IronHeartConsulting/IBPV2/Docs/Photos/thumb_IMG_0899_1024.jpg

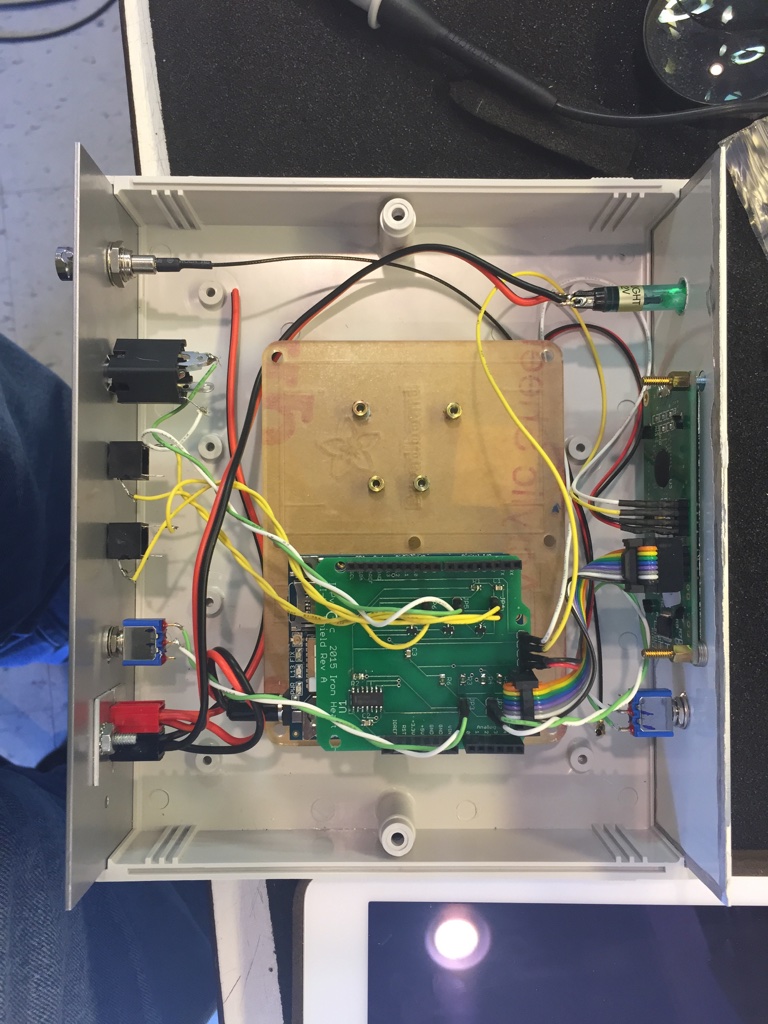
Docs/Photos/thumb_IMG_0899_1024.jpg
