IronHeartConsulting/IBPV2/Docs/Photos/IMG_0892_1024.jpg

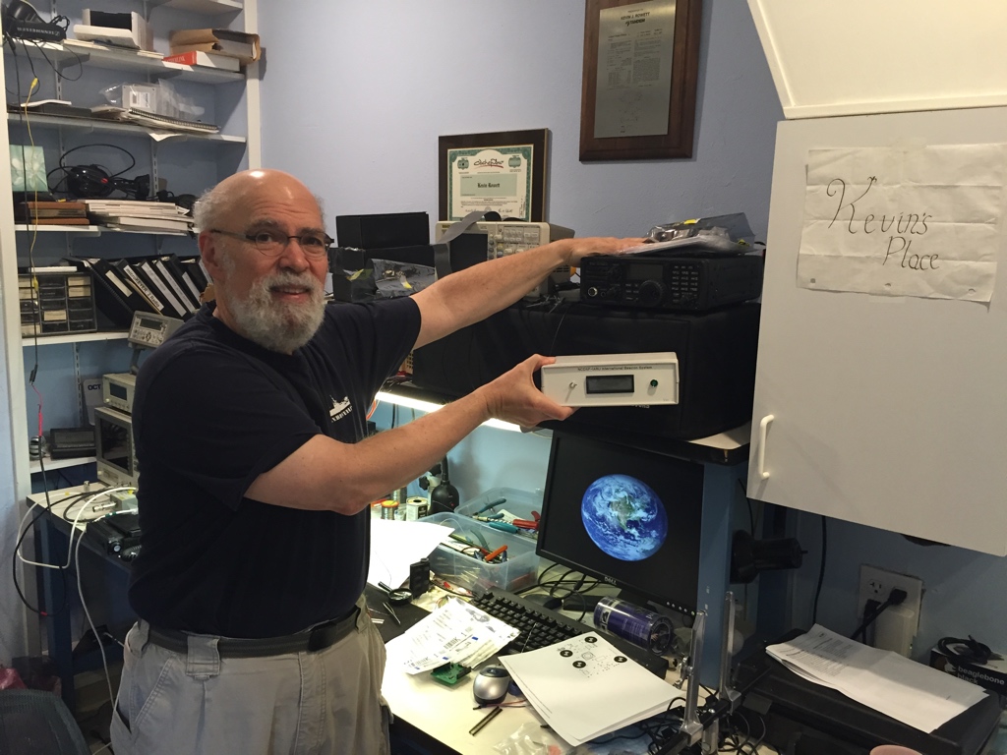
Docs/Photos/IMG_0892_1024.jpg
