IronHeartConsulting/IBPV2/Hardware/Electricial/Rev E controller/CI_V_Shield_Rev_D/Gerbers/readme.pdf

## readme.txt - Beacon Controller PCB

Iron Heart Consulting P/N 100-0004-500 Rev E 8/8/2016

Added Vscore layer - krowett - 8/8/16 - based on email with Sunstone

Stack Order | File suffix | Description | Eagle layer info, other notes
1 | .crc | Comp side Cream Frame | (31) tCream
2 | .plc | Comp side silk screen | (20) Dimension, (21) tPlace, (25), tNames
3 | .stc | Comp side solder stop mask | (29) tStop
4 | .cmp | Component Side | (1) top, (17) pads, (18) Vias
5 | .ly2 | Inner Layer - 2 | (2) Route2, (17) Pads, (18) Vias
6 | .l15 | Inner Layer -15 | (15) Route15, (17) Pads, (18) Vias
7 | .sol | Solder Side | (16) Bottom, (17) Pads, (18) Vias
8 | .sts | Solder Side solder stop mask | (30) bStop
9 | .pls | Solder side silk screen | (20) Dimension, (22) bPlace, (26) bNames

10 | .crc | Solder side Cream Frame | (32) bCream
11 | .vsc | VSCORE - board outline | (102) VScore
