IronHeartConsulting/IBPV2/Hardware/Enclosure/Mechanicals Rev B/connector_holes_mill_rear_endpanel.txt

( connector_holes_mill_rear_endpanel )
( File created: Wednesday September 21 2016 - 04:25 PM)
( for Mach2/3 from Vectric )
( Material Size)
( X= 6.000, Y= 6.000, Z= 0.063)
()
(Toolpaths used in this file:)
(connector holes)
(Tools used in this file: )
(1 = End Mill {0.125 inch})
N100G00G20G17G90G40G49G80
N110G70G91.1
N120T1M06
N130 (End Mill {0.125 inch})
N140G00G43Z0.8000H1
N150S12000M03
N160(Toolpath:- connector holes)
N170()
N180G94
N190X0.0000Y0.0000F10.0
N200G00X1.7092Y2.9206Z0.2000
N210G1Z-0.0630F4.0
N220G1X1.7150Y2.9179F10.0
N230G1X1.7211Y2.9157
N240G1X1.7273Y2.9142
N250G1X1.7337Y2.9134
N260G1X1.7402Y2.9132
N270G1X1.7468Y2.9137
N280G1X1.7532Y2.9149
N290G1X1.7618Y2.9176
N300G1X1.7708Y2.9214
N310G1X1.7735Y2.9229
N320G1X1.7768Y2.9251
N330G1X1.7801Y2.9279
N340G1X1.7835Y2.9311
N350G1X1.7868Y2.9348
N360G1X1.7899Y2.9390
N370G1X1.7928Y2.9434
N380G1X1.7954Y2.9481
N390G1X1.7976Y2.9530
N400G1X1.7995Y2.9579
N410G1X1.8009Y2.9628
N420G1X1.8019Y2.9675
N430G1X1.8025Y2.9719
N440G1X1.8027Y2.9759
N450G1X1.8026Y2.9795
N460G1X1.8022Y2.9826
N470G1X1.8001Y2.9914
N480G1X1.7973Y2.9990
N490G1X1.7940Y3.0056
N500G1X1.7902Y3.0114
N510G1X1.7858Y3.0166
N520G1X1.7805Y3.0214
N530G1X1.7743Y3.0259
N540G1X1.7660Y3.0306
N550G1X1.7582Y3.0343
N560G1X1.7576Y3.0345
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
%
