IronHeartConsulting/IBPV2/Docs/Photos/IMG_0868_1024.jpg

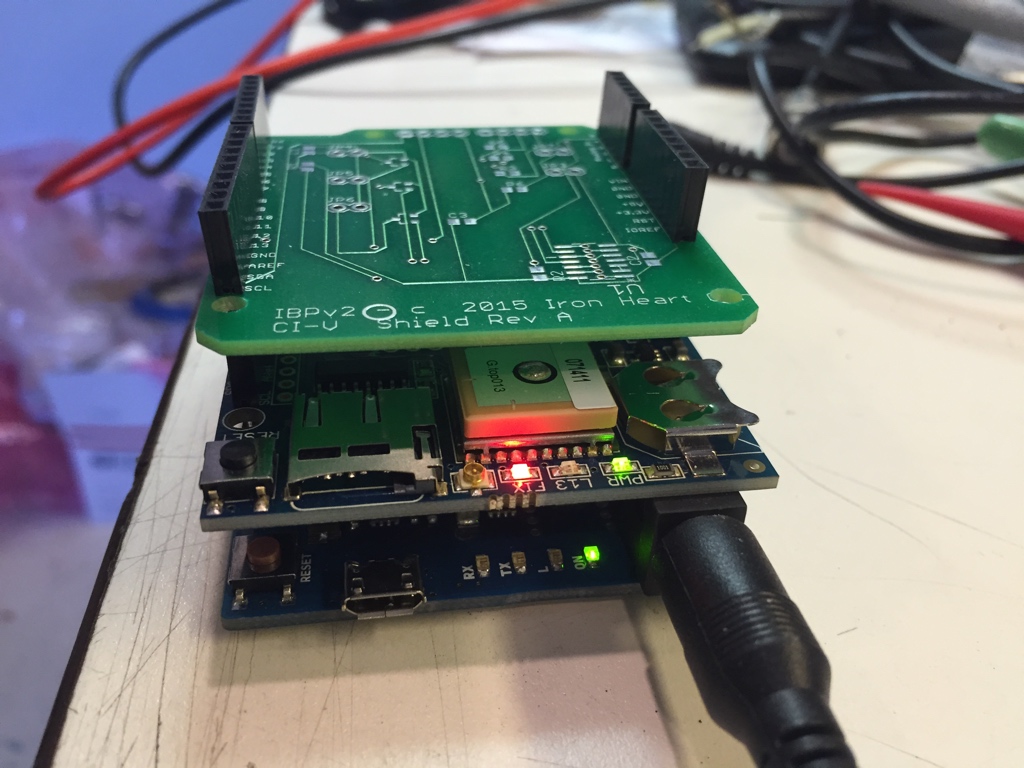
Docs/Photos/IMG_0868_1024.jpg
