IronHeartConsulting/IBPV2/Docs/Photos/IMG_0886_1024.jpg

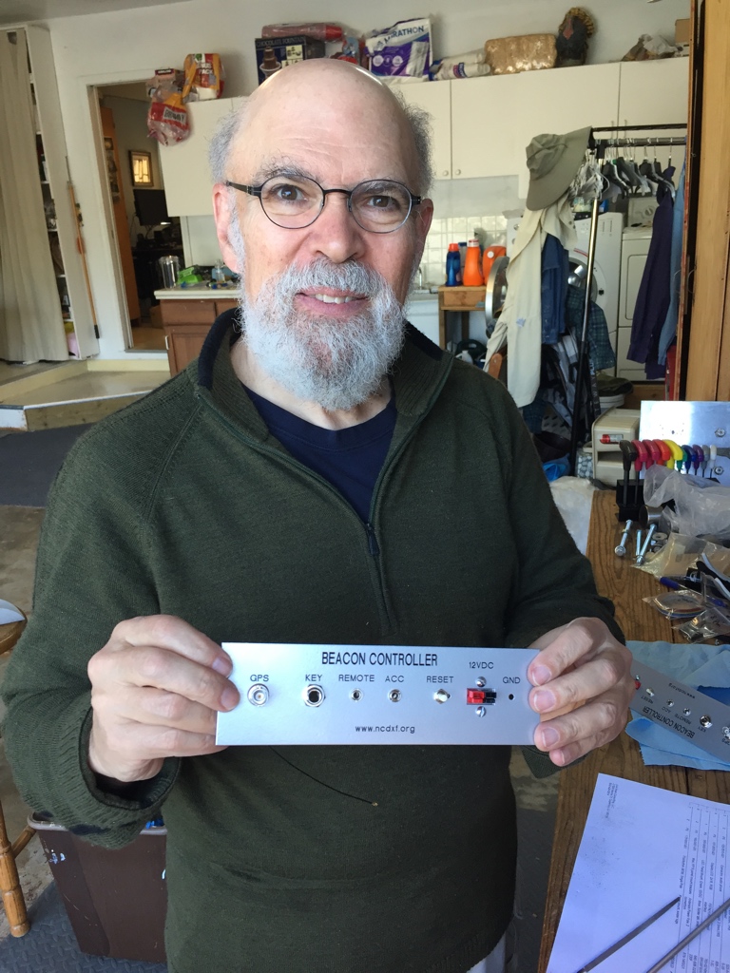
Docs/Photos/IMG_0886_1024.jpg
