IronHeartConsulting/IBPV2/Docs/Photos/IMG_0894_1024.jpg

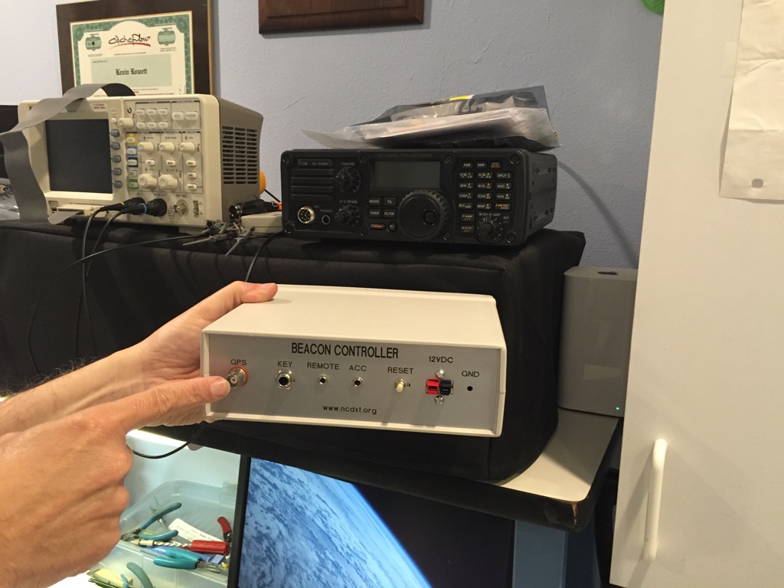
Docs/Photos/IMG_0894_1024.jpg
