IronHeartConsulting/IBPV2/Docs/Photos/IMG_0913.JPG

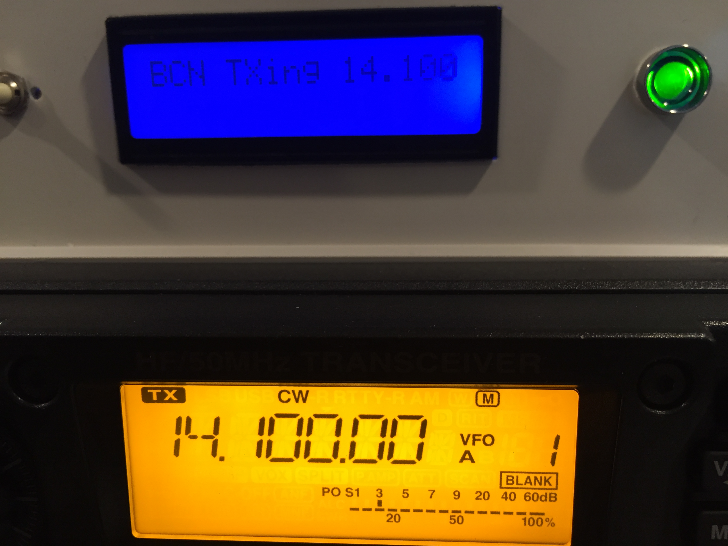
Docs/Photos/IMG_0913.JPG
