IronHeartConsulting/IBPV2/Docs/waveforms/NewFile4.bmp

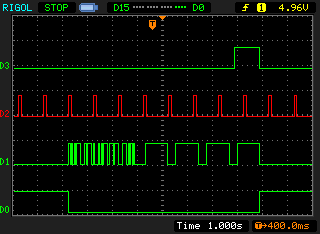
Docs/waveforms/NewFile4.bmp
