IronHeartConsulting/IBPV2/Docs/waveforms/NewFile5.bmp

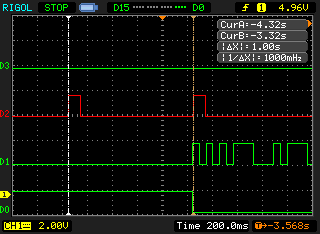
Docs/waveforms/NewFile5.bmp
