IronHeartConsulting/IBPV2/Docs/waveforms/NewFile6.bmp

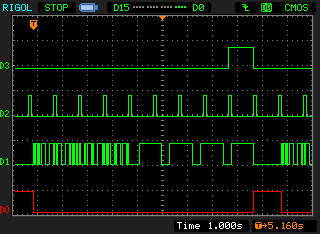
Docs/waveforms/NewFile6.bmp
