IronHeartConsulting/IBPV2/Hardware/ECOs/ECO_1_CI_V_drawing.png

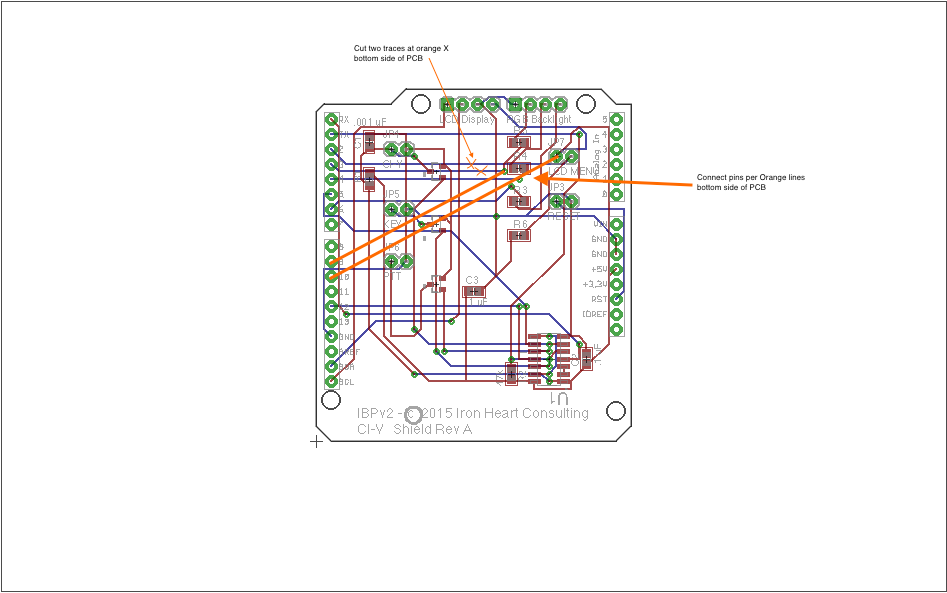
Hardware/ECOs/ECO_1_CI_V_drawing.png
