IronHeartConsulting/IBPV2/Hardware/Enclosure/Outside_label.graffle/image1.png

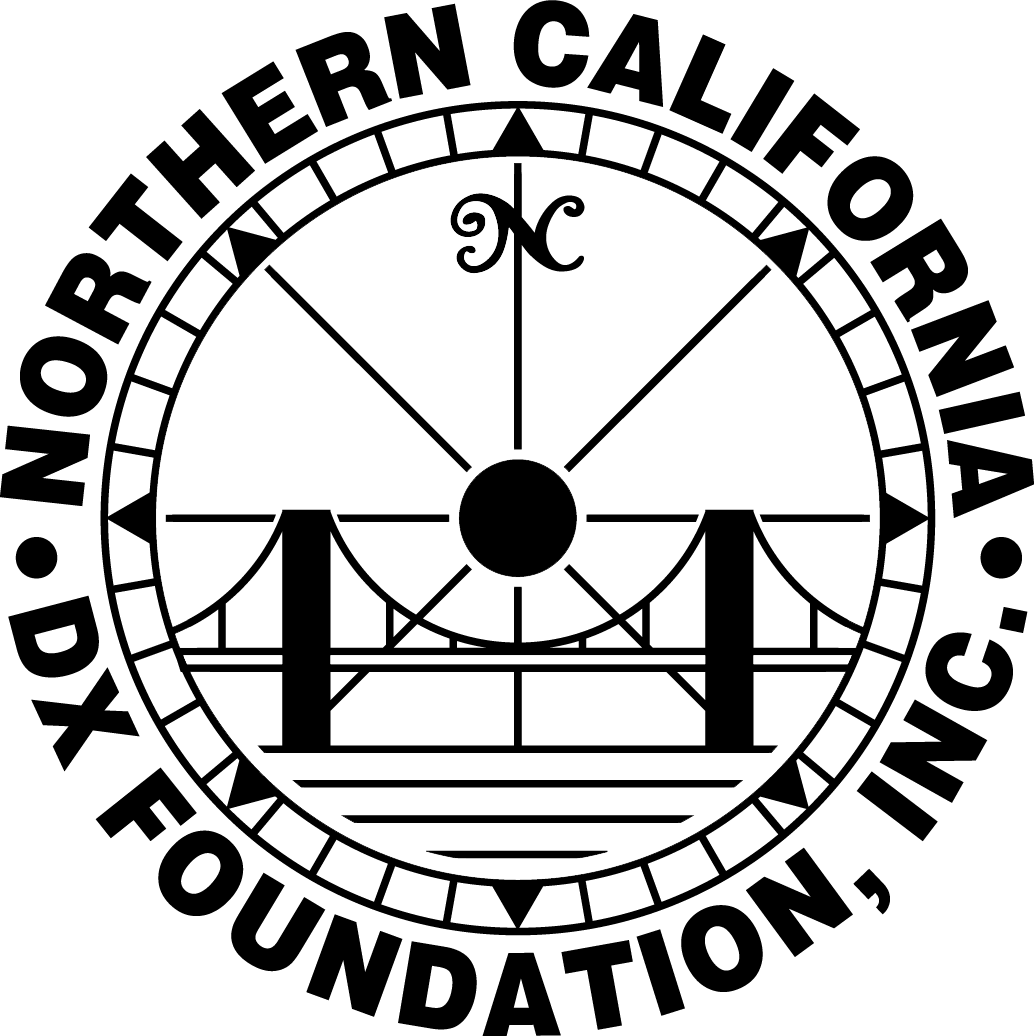
Hardware/Enclosure/Outside_label.graffle/image1.png
