IronHeartConsulting/IBPV2/Hardware/Electricial/Rev E controller/SC Release/100-0004-100_BOM.xlsx

Sheet: 100-0004-200 Rev E
Item Num | Qty | Value | Part Num | Package | REFDES | Description | Detail | VID | Vendor Part Num | mfg name | mfg part number | pkg code | Notes
1 | 3 | FIDUCIAL | * | FIDUCIAL_1MM | U$1, U$6, U$7 | * | * | * | * | * | * | * | DNP
2 | 3 | 220 | 110-0001-010 | R0805 | R1, R3, R11 | Resistor, SMD, 0805, thick film, 1%, 1/4W | 220ohm | ME | 660-SG73S2ATTD2200F | KOA Speer | SG73S2ATTD2200F | 805
3 | 1 | 330 | 110-0001-012 | R0805 | R4 | Resistor, SMD, 0805, thick film, 1%, 1/4W | 330 | ME | 660-SG73S2ATTD3300F | KOA Speer | SG73S2ATTD3300F | 805
4 | 1 | 4.7k | 110-0001-020 | R0805 | R6 | Resistor, SMD, 0805, thick film, 1%, 1/4W | 4.7k | ME | 660-SG73S2ATTD4701F | KOA Speer | SG73S2ATTD4701F | 805
5 | 1 | 10k | 110-0001-025 | R0805 | R5 | Resistor, SMD, 0805, thick film, 1%, 1/4W | 10k | ME | 660-SG73S2ATTD1002F | KOA Speer | SG73S2ATTD1002F | 805
6 | 1 | 10 | 110-0001-027 | 805 | R16 | Resistor, SMD, 0805, thick film, 1%, 1/4W | 10 | ME | 660-SG73P2ATTD10R0F | KOA Speer | SG73P2ATTD10R0F | 805
7 | 1 | 1k | 110-0001-029 | R0805 | R10 | Resistor, SMD, 0805, thick film, 1%, 1/4W | 1K | ME | 660-SG73S2ATTD1001F | KOA Speer | SG73S2ATTD1001F | 805
8 | 1 | 47k | 110-0001-030 | R0805 | R2 | Resistor, SMD, 0805, thick film, 1%, 1/4W | 47k | ME | 660-SG73S2ATTD4702F | KOA Speer | SG73S2ATTD4702F | 805
9 | 1 | 1.47M | 110-0002-010 | 805 | R12 | Resistor, SMD, 0805, thick film, 1%, 1/8W | 1.4M | ME | 660-RK73H2ATTD1404F | KOA Speer | RK73H2ATTD1404F | 805
10 | 1 | 280k | 110-0002-015 | 805 | R7 | Resistor, SMD, 0805, thick film, 1%, 1/8W | 280k | ME | 660-RK73H2ATTD2803F | KOA Speer | RK73H2ATTD2803F | 805
11 | 1 | 187k | 110-0002-030 | 805 | R9 | Resistor, SMD, 0805, thick film, 1%, 1/8W | 187k | ME | 660-RK73H2ATTD1873F | KOA Speer | RK73H2ATTD1873F | 805
12 | 1 | 105k | 110-0003-010 | 805 | R17 | Resistor, SMD, 0805, thin film, .1%, 100mW, 10ppm | 105k | ME | 279-RN73C2A105KBTDF | TE | RN73C2A105KBTDF | 805
13 | 1 | 1uF | 120-0001-009 | 805 | C4 | Cap, SMD, 0805, MLCC, X7R, 15% Tol, 50V | 1 uF | ME | 80-C0805C105K5R | KEMET | C0805C105K5R | 805
14 | 3 | .1 uF | 120-0001-010 | C0805 | C1, C2, C15 | Cap, SMD, 0805, MLCC, X7R, 15% Tol, 50V | .1 uF | ME | 80-C0805C104K5R | KEMET | C0805C104K5R | 805
15 | 1 | 47nF | 120-0001-013 | 805 | C9 | Cap, SMD, 0805, MLCC, X7R, 15% Tol, 50V | .047uF | ME | 80-C0805C473K5R | KEMET | C0805C473K5R | 805
16 | 1 | .001 uF | 120-0001-015 | C0805 | C3 | Cap, SMD, 0805, MLCC, X7R, 15% Tol, 50V | .001uF | ME | 80-C0805C102K5R | KEMET | C0805C102K5R | 805
17 | 1 | .01uF | 120-0001-020 | 805 | C6 | Cap, SMD, 0805, MLCC, X7R, 15% Tol, 50V | .01 uF | ME | 80-C0805C103K5R | KEMET | C0805C103K5R | 805
18 | 1 | .22uF | 120-0001-022 | 805 | C23 | Cap, SMD, 0805, MLCC, X7R, 15% Tol, 50V | .22 uF | ME | 80-C0805C224K5R | KEMET | C0805C224K5RACTU | 805
19 | 1 | 2.2uF | 120-0002-011 | 805 | C22 | CAP, SMD, 0805, MLCC, X7F, 16V, 10% | 2.2uF | ME | 963-EMK212B7225KG-T | Taiyo Yuden | EMK212B7225KG-T | 805
20 | 1 | 10uF | 120-0003-010 | 1210 | C7 | Cap, SMD, 1210, MLCC, X7R, 10% Tol, 25V | 10uF | ME | 963-TMK325B7106KN-TR | Taiyo Yuden | TMK325B7106KN-TR | 1210
21 | 2 | 4.7uF | 120-0003-011 | 1210 | C5, C21 | Cap, SMD, 1210, MLCC, X7R, 10% Tol, 25V | 4.7uF | ME | 963-TMK325B7475KN-T | Taiyo Yuden | TMK325B7475KN-T | 1210
22 | 1 | 47pF | 120-0004-010 | 805 | C10 | Cap, SMD, 0805, MLCC, C0G, 5% Tol, 50V | 47pF | ME | 80-C0805C470J5G | KEMET | C0805C470J5G | 805
23 | 1 | 22pF | 120-0004-011 | 805 | C8 | Cap, SMD, 0805, MLCC, C0G, 5% Tol, 50V | 22pF | ME | 80-C0805C220J5G | KEMET | C0805C220J5G | 805
24 | 1 | 5pF | 120-0004-013 | 805 | C20 | Cap, SMD, 0805, MLCC, C0G, 5% Tol, 50V | 5.6pF | ME | 80-C0805C569J5G | KEMET | C0805C569J5G | 805
25 | 1 | 100uF | 120-0005-050 | CAPCP6032X280N | C11 | Cap, SMD, 2312, TANT, 10V | 100uF | ME | 581-TPSC107M010R0075 | AVX | TPSC107M010R0075 | 2312
26 | 2 | CTL Signals | 125-0019-001 | 1X08_PIN1_NO_SILK | JP1,JP3 | header, right angle 1 rows, 10p, 2.54mm | THT | ME | 710-61301011021 | Wurth | 61301011021 | * | Made From
27 | 1 | MENU BTN | 125-0019-001 | 1X02 | JP2 | header, right angle 1 rows, 10p, 2.54mm | THT |  |  |  |  |  | Made From
28 | 1 | SMA-SMD | 125-0020-001 | SMA-SMD | X2 | Connector,RF, SMA, SMD, GOLD | Right Angle | ME | 530-142-0701-301 | Cinch | 142-0701-301 | *
29 | 1 | MBRA140 | 140-0001-001 | SMA-DIODE | D2 | DIO,SMD,Schottky, 1A, 40V | MBRA140 | ME | 863-MBRA140T3G | On Semi | MBRA140T3G | *
30 | 1 | PMEG4005EJ | 140-0003-001 | SOD-323 | D3 | DIO,SMD,Schottky, 40V, 200mW | PMEG4005EJ | ME | 771-PMEG4005EJ-T/R | NXP | PMEG4005EJ,115 | SOD-323
31 | 1 | 500mA | 145-0001-001 | R1206 | F1 | FUSE,SMD, 500mA, 1206, fast blow | * | ME | 581-F1206B0R50FSTR | AVX | F1206B0R50FSTR | 1206
32 | 1 | 100uH | 155-0001-001 | SLF7045 | L2 | INDUCTOR, SMD, 100uH | .5 AMPS, Switching PS | ME | 810-SLF7045T-101M | TDK | SLF7045T-101MR50-PF | *
33 | 1 | 47nH | 155-0002-001 | 805 | L1 | INDUCTOR,SMD, 47nH | 1.25A, SRF 1500MHz, 0805 | ME | 81-LQW2BAN47NJ00L | Murata | LQW2BAN47NJ00L | *
34 | 1 | 4.7uH | 155-0003-001 | 805 | L5 | INDUCTOR,SMD, 4.7uH, SMD, 0805 | 300mA | ME | 81-LQH2MCN4R7M02L | Murata | LQH2MCN4R7M02L | 805
35 | 1 |  | 155-0004-001 | L2012C | L3 | INDUCTOR, FB, SMD, 10mOhm | * | ME | 81-BLM21PG220SZ1D | Murata | BLM21PG220SZ1D | 805
36 | 1 |  | 160-0007-001 | CHIPLED_0805 | GPSLOCK | LED, SMD,CHIPLED, 0805, 45mcd | Green | ME | 720-LGR971-KN-1 | OSRAM | LGR971-KN-1 | 805
37 | 1 |  | 165-0001-001 | CR1220-SMD | BH2 | Battery holder, single coin cell, 12mm, SMD | CR1220 style | ME | 534-3000TR | Keystone | 3000TR | * | On BOTTOM
38 | 3 | MOSFET-NCHANNELBSS123LT1G | 185-0001-001 | SOT23-3 | Q1, Q2, Q3 | MOSFET, N-channel, SMD | Enh, 60V, 1.3ohm | ME | 771-2N7002P-215 | NXP | 2N7002P,215 | *
39 | 1 | MC74HC14ADG | 200-0001-001 | SOIC127P600X175-14N | U1 | Inverter, HC14, SMD | * | ME | 863-MC74HC14ADG | On Semiconductor | MC74HC14ADG | *
40 | 1 | LT1761ES5-5PBF | 230-0002-001 | SOT95P280X100-5N | U2 | LDO, 100mA, 5V, TSOT-23-5 | Micropower, Low Noise | DK | LT1761ES5-5#TRPBFCT-ND | Linear | LT1761ES5-5#PBF | *
41 | 1 | LTC3631IMS8EPBF | 230-0003-001 | SOP65P490X110-9N | U3 | switch controller, Buck, current mode | MS8E | LTC | LTC3631EMS8E#PBF | Linear | LTC3631EMS8E#PBF | *
42 | 1 | LT3483IS6PBF | 230-0005-001 | SOT95P280X100-6N | U8 | Buck, Boost, Charge Pump, Flyback Switching Regulator IC Negative Adjustable -2.5V 1 Output 170mA (Switch) | Negative | DK | LT3483ES6#TRMPBFCT-ND | Linear | LT3483ES6#TRMPBF | TSOT-23
43 | 1 |  | 240-0001-001 | FGPMMOPA6H | U5 | IC,SMD, GPS receiver | MT3339 | AF | 790 | GTOP | FGPMMOPA6H | *
44 | 2 | 8p | 125-0022-002 | header |  | header, vertical 1 rows, 8p, 2.54mm | THT |  |  |  |  |  | Insert from Bottom
45 | 1 | 10p | 125-0022-001 | header |  | header, vertical 1 rows, 10p, 2.54mm | THT |  |  |  |  |  | Insert from Bottom
44 | 1 | 6p | 125-0022-003 | header |  | header, vertical 1 rows, 6p, 2.54mm | THT |  |  |  |  |  | Insert from Bottom

Sheet: On-Hand
Iem Num | Qty | Value | Part Num | QTY On Hand
1 | 3 | FIDUCIAL | * | infinite
2 | 3 | 220 | 110-0001-010 | plenty
3 | 1 | 330 | 110-0001-012 | plenty
4 | 1 | 4.7k | 110-0001-020 | plenty
5 | 1 | 10k | 110-0001-025 | plenty
6 | 1 | 10 | 110-0001-027 | 39
7 | 1 | 1k | 110-0001-029 | 39
8 | 1 | 47k | 110-0001-030 | 100
9 | 1 | 1.47M | 110-0002-010 | plenty
10 | 1 | 280k | 110-0002-015 | plenty
11 | 1 | 187k | 110-0002-030 | plenty
12 | 1 | 105k | 110-0003-010 | 39
13 | 1 | 1uF | 120-0001-009 | plenty
14 | 3 | .1 uF | 120-0001-010 | plenty
15 | 1 | 47nF | 120-0001-013 | 39
16 | 1 | .001 uF | 120-0001-015 | plenty
17 | 1 | .01uF | 120-0001-020 | 39
18 | 1 | .22uF | 120-0001-022 | 39
19 | 1 | 2.2uF | 120-0002-011 | 39
20 | 1 | 10uF | 120-0003-010 | plenty
21 | 2 | 4.7uF | 120-0003-011 | 78
22 | 1 | 47pF | 120-0004-010 | plenty
23 | 1 | 22pF | 120-0004-011 | plenty
24 | 1 | 5pF | 120-0004-013
25 | 1 | 100uF | 120-0005-050 | 39
26 | 2 | CTL Signals | 125-0019-001 | 0
27 | 1 | MENU BTN | 125-0019-001 | 0
28 | 1 | SMA-SMD | 125-0020-001 | 0
29 | 1 | MBRA140 | 140-0001-001 | 39
30 | 1 | PMEG4005EJ | 140-0003-001 | 0
31 | 1 | 500mA | 145-0001-001 | 35
32 | 1 | 100uH | 155-0001-001 | plenty
33 | 1 | 47nH | 155-0002-001 | plenty
34 | 1 | 4.7uH | 155-0003-001 | 38
35 | 1 |  | 155-0004-001 | 39
36 | 1 |  | 160-0007-001 | 38
37 | 1 |  | 165-0001-001 | 39
38 | 3 | MOSFET-NCHANNELBSS123LT1G | 185-0001-001 | plenty
39 | 1 | MC74HC14ADG | 200-0001-001 | plenty
40 | 1 | LT1761ES5-5PBF | 230-0002-001 | 40
41 | 1 | LTC3631IMS8EPBF | 230-0003-001 | enough
42 | 1 | LT3483IS6PBF | 230-0005-001 | 38
43 | 1 |  | 240-0001-001 | 25
44 | 2 | 8p | 125-0022-002 | 0
45 | 1 | 10p | 125-0022-001 | 0
44 | 1 | 6p | 125-0022-003 | 0

Sheet: Top level
Level | Item Num | Qty | Part Num | Description | Detail | VID | Vendor Part Num | mfg name | mfg part number | Notes
1 |  | 1 | 040-0001-001 | Beacon Package | V2
2 |  | 1 | 040-0002-001 | Assembled Controller package
2 |  | 1 |  | Antenna, vertical, 5 band, strengthened
2 |  | 1 |  | Antenna, GPS Timing, N connector, 26dB
2 |  | 1 |  | Power Supply, 12VDC, 30AMP, 110/220 input
2 |  | 1 |  | Cable, Coax, RG-213, PL259 to PL259, UV | ?? Ft
2 |  | 1 |  | Cable, Coax, LMR-400, N to sma, UV | 50 ft
2 |  |  |  | Lightning Arrestor,
2 |  |  |  | Doc, Installation
2 |  |  |  | Label, controller
 |  |  |  | PCBA, beacon controller | Rev E
 |  |  |  | Arduino, Leonardo
 |  |  |  | Doc, mods, Leonardo | Rev A
 |  |  |  | Mated controller boards
 |  |  |  | Front End Panel
 |  |  |  | Blank, Endpanel
 |  |  |  | DWG, front endpanel fabrication
 |  |  |  | LCD Display
 |  | 4 |  | Nuts, 4-40
 |  |  |  | Pushbutton | Menu
 |  |  |  | Power Indicator | Green
 |  |  |  | DWG, Label, Front End Panel
 |  |  |  | Assembly Instructions
 |  |  |  | Rear End Panel
 |  |  |  | Blank, Endpanel
 |  |  |  | DWG, rear endpanel fabrication
 |  |  |  | Connector, Circular, DIN, Flange | 8p
 |  | 4 |  | Nuts, 4-40
 |  |  |  | screws, 4-40, pan head | ?? Length
 |  |  |  | Pushbutton | reset
 |  |  |  | DWG, Label, Rear End Panel
 |  |  |  | Assembly Instructions
 |  |  |  | pan
 |  |  |  | DWG, pan fabrication
 |  |  |  | stand-offs, swage, 4-40, .187 OD, 3/16 L | 6"
 |  |  |  | Cable, Coax, RG-316, SMA M RA-SMA F panel mount
 |  |  |  | Cable, assembly, LCD
 |  |  |  | Cable, assembly, control
 |  |  |  | Cable, assembly, menu button
 |  |  |  | Doc, assembly, controller chassis
 |  | 4 |  | screws, 4-40 | secure PCBAs
 |  | 4 |  | Spacers, round, #4 bore, nylon | CI-V to Leo
 |  |  |  | Enclosure
