IronHeartConsulting/IBPV2/Hardware/Electricial/Power_Injector_Asm_kit.xlsx

Item | Qty | P/N | Title | Detail | Ref(m) | Vend-P/N | Mfr | Mfr-P/N
Top |  | 100-0002-200 | PCA, Power Injector, GPS Antenna | 5V, 35mA from 7-12VDC
1 | 1 | 120-0003-010 | Cap, SMD, 1210, MLCC, X7R, 10% Tol, 25V | 10uF | C4 | 963-TMK325B7106KN-TR | Taiyo Yuden | TMK325B7106KN-TR
2 | 1 | 120-0002-009 | CAP, SMD, 0805, MLCC, X7F, 16V, 10% | 4.7uF | C6 | 963-EMK212B7475KG-T | Taiyo Yuden | EMK212B7475KG-T
3 | 1 | 125-0011-001 | header, straight, 1 rows, 2p, 2.54mm | THT | JP1
4 | 1 | 155-0001-001 | INDUCTOR, SMD, 100uH | .5 AMPS, Switching PS | L1 | 810-SLF7045T-101M | TDK | SLF7045T-101MR50-PF
5 | 1 | 120-0001-010 | Cap, SMD, 0805, MLCC, X7R, 15% Tol, 50V | .1 uF | C1 | 80-C0805C104K5R
6 | 1 | 120-0001-009 | Cap, SMD, 0805, MLCC, X7R, 15% Tol, 50V | 1 uF | C2 | 80-C0805C105K5R
7 | 1 | 120-0004-010 | Cap, SMD, 0805, MLCC, C0G, 5% Tol, 50V | 47pF | C7 | 80-C0805C470J5G
8 | 1 | 120-0004-011 | Cap, SMD, 0805, MLCC, C0G, 5% Tol, 50V | 22pF | C9 | 80-C0805C220J5G
9 | 2 | 125-0013-001 | u.FL, SMT, male recept, gold |  | J1,J2 | 798-UFLRSMT101 | Hirose | U.FL-R-SMT-1(01)
10 | 1 | 110-0002-010 | Resistor, SMD, 0805, thick film, 1%, 1/8W | 1.4M | R1 | 660-RK73H2ATTD1404F
11 | 1 | 110-0002-015 | Resistor, SMD, 0805, thick film, 1%, 1/8W | 280k | R3 | 660-RK73H2ATTD2803F
12 | 1 | 155-0002-001 | INDUCTOR,SMD, 47nH | 1.25A, SRF 1500MHz, 0805 | L2 | 81-LQW2BAN47NJ00L | Murata | LQW2BAN47NJ00L
13 | 1 | 230-0003-001 | switch controller, Buck, current mode | MS8E | U2 | LTC3631EMS8E#PBF
 |  |  |  |  |  | LTC3631EMS8E#PBF-ND | Linear | LTC3631EMS8E#PBF
14 | 1 | 230-0002-001 | LDO, 100mA, 5V, TSOT-23-5 | Micropower, Low Noise | U1 | LT1761ES5-5#PBF
 |  |  |  |  |  | LT1761ES5-5#TRPBFCT-ND | Linear | LT1761ES5-5#PBF
15 | 1 | 110-0002-020 | Resistor, SMD, 0805, thick film, 1%, 1/8W | 187k | R2 | 660-RK73H2ATTD1870F
16 | 1 | 100-0002-500 | PCB, Power Injector, GPS Antenna | Eagle BRO (CAD) FILE |  |  | Sunstone PCB
