IronHeartConsulting/IBPV2/Hardware/Electricial/Rev E controller/CI_V_Shield_Rev_D/CI_V.dxf

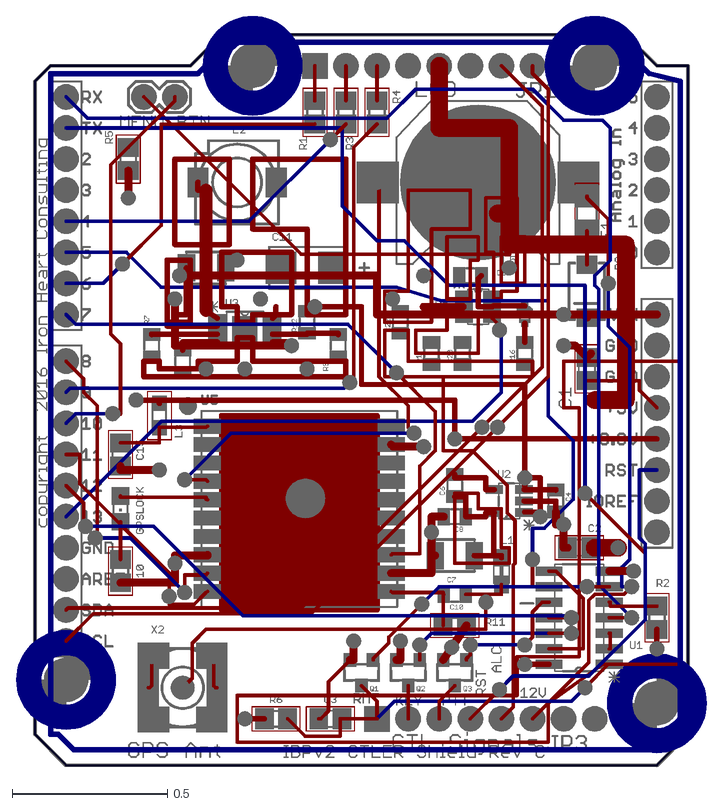
[picture p13: CAD file, 2016-09-22]
Hardware/Electricial/Rev E controller/CI_V_Shield_Rev_D/CI_V.dxf
2.22 x 2.42
