IronHeartConsulting/IBPV2/Hardware/Enclosure/Mechanicals Rev B/rear_endpanel.stl

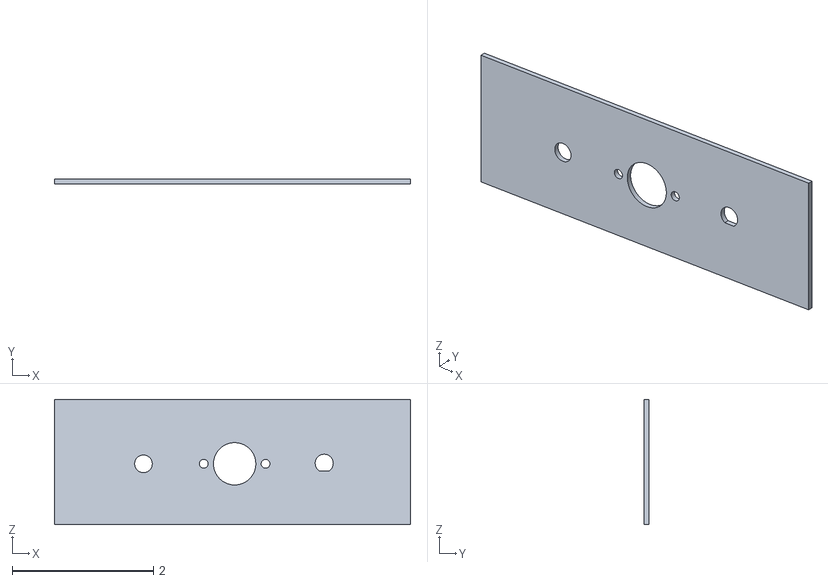
[picture p14: CAD file, 2016-09-22]
Hardware/Enclosure/Mechanicals Rev B/rear_endpanel.stl
5.04 x 0.065 x 1.77
