IronHeartConsulting/IBPV2/Hardware/Enclosure/Mechanicals Rev B/Front_endpanel.stl

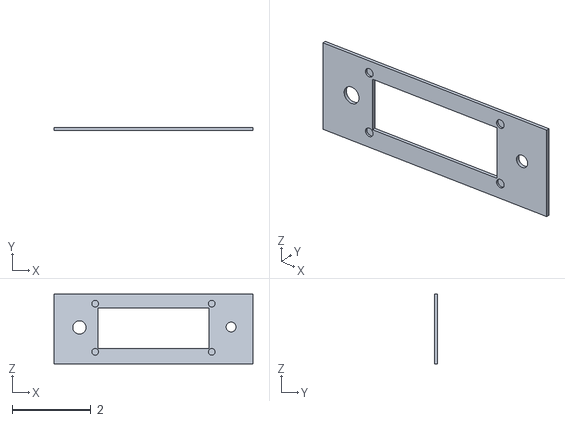
[picture p15: CAD file, 2016-09-22]
Hardware/Enclosure/Mechanicals Rev B/Front_endpanel.stl
5.04 x 0.065 x 1.77
