IronHeartConsulting/IBPV2/Hardware/Enclosure/Mechanicals Rev B/Pan_withOUT_standoffs_Rev_B.stl

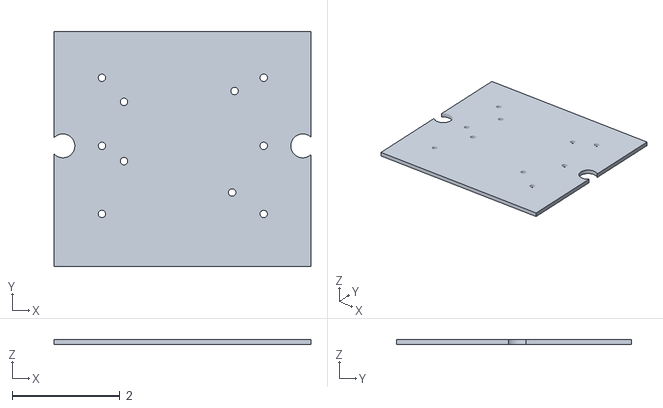
[picture p16: CAD file, 2016-09-22]
Hardware/Enclosure/Mechanicals Rev B/Pan_withOUT_standoffs_Rev_B.stl
4.78 x 4.37 x 0.1
