IronHeartConsulting/IBPV2/Datasheets_manuals/adafruit_products_gpsshield.png

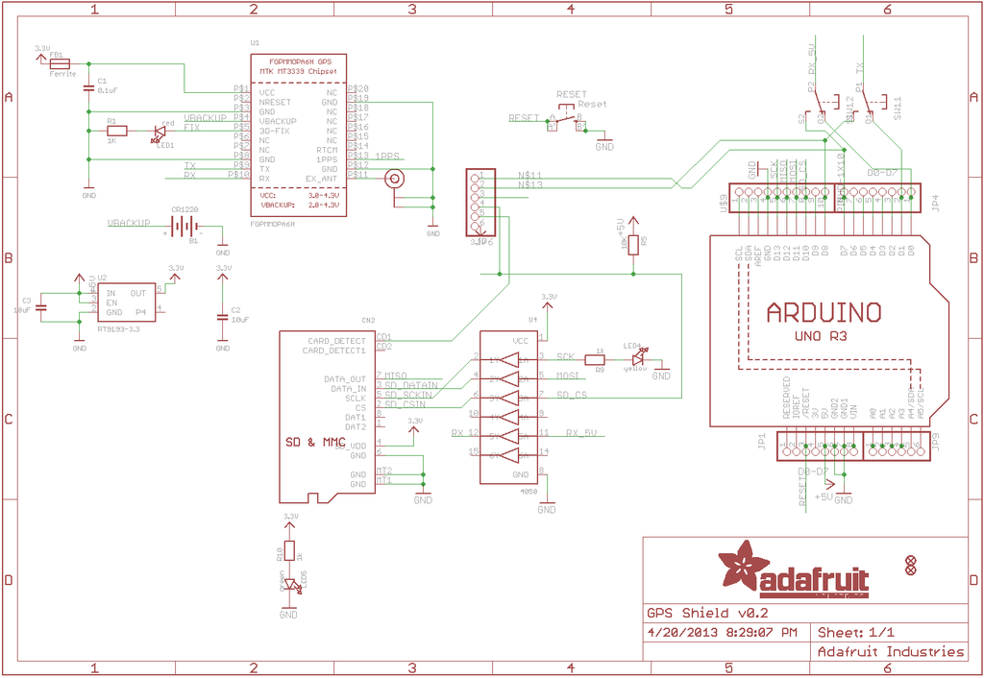
Datasheets_manuals/adafruit_products_gpsshield.png
