IronHeartConsulting/IBPV2/(threads)

Thread 2 (2015-06-18):

At init, sometimes controller seems out of synch

K6TD, 2015-06-18:
On the first boot, if the init completes just as it's time to start the transmission, the controller seems out of synch.  CW ID isn't right, long dashes don't seem to be long enough, and band changes are erratic.

Might be that the time of day jumps into the middle of a state.

wa5znu, 2015-06-20:
It is supposed to suppress transmission until it has sent an id.
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

K6TD, 2015-06-23:
Haven't heard this re-occur.

K6TD, 2015-06-25:
This may be caused by the time wheel not starting on the right minute.  wall_ticks is defined as 'volatile byte'.  In the GPS-DO routine, it's used in a computation.  The entire computation may get truncated to a byte operation, thereby overflowing when minutes goes above 04.  No direct evidence yet.

K6TD, 2015-06-25:
ah...here is the code from TinyGPS::crack_datetime:

void TinyGPS::crack_datetime(int *year, byte *month, byte *day,
  byte *hour, byte *minute, byte *second, byte *hundredths, unsigned long *age)
{

This looks like 'minute' could end up overflowing in GPS_do

GeoNomad, 2015-06-25:
gps.crack_datetime(&year, &month, &day, &hour, &minute, &second, &hundredths, &age);
  if (age == TinyGPS::GPS_INVALID_AGE)
     ... oops
else
   ... OK

Looks like you are not checking for invalid age ...

wa5znu, 2015-06-25:
The invalid-age thing does look like it needs to be be fixed; thank you @GeoNomad .  GPS is not needed very often, but we do need to start listening to it, then but we do need to know when we get a valid parse from it.

wa5znu, 2015-06-25:
@K6TD checking to see if code looks like it will overflow. This looks like the computation:

  wall_ticks = (wall_ticks+1) % (3*60);

K6TD, 2015-06-25:
That code should be fine, as wall ticks range is 0-179, less than 8 bits, or 256.
The place that worried me was this: wall_ticks = ((minute * 60) + second) % (3*60);
In boolean gps_discipline_clock(long tries) {

minute is a byte, with a range of 0-59. (I hope, NOT 1-60).  It's cast as a byte. The compiler might limit the computation minute * 60 to a byte then also.  At a value of 5, the result will be 300, and it might wrap, truncate, etc, resulting in the wrong wall_ticks value. An assertion check might be 0<= wall_ticks < 180.

leighklotz, 2015-06-25:
My test code on Intel doesn't show this to be a problem.  I'll put it in a gist.

wa5znu, 2015-06-25:
I tried it on Intel.  I haven't tried it on Arduino yet.
https://gist.github.com/wa5znu/ffb603f96bbdf209c0ba makes it seem like the overflow isn't happening.

K6TD, 2015-06-25:
I expect Intel processor/compilers to get it right.  It's the Arduino/Atmel compiler that has byte wide machine instructions, and the compiler might use them.

K6TD, 2015-06-26:
Overflow isn't happening.  See this GIST. https://gist.github.com/e14a4b8ba5f93bbbbde3.git
The only thing I can think of is not checking for a fix.

wa5znu, 2015-06-26:
I ran a test too.
https://gist.github.com/wa5znu/e3480cdb7cdc0ffa13bb

K6TD, 2015-06-29:
Will apply Peter's suggestion of testing for invalid age test.

K6TD, 2015-06-29:
scanning the log file, didn't find any occurrences of clock done: 1 - doesn't look like it ever got thru the retries loop with a good packet.

wa5znu, 2015-06-29:
The setup() routines goes through or else it wouldn't have the time at all.  So perhaps it just needs to be more aggressive about tries, without consuming all the tick time.

K6TD, 2015-07-01:
Fixed the GPS DO code such that it now gets synch every time, an with a fix age of usually 3ms.  Added a bit of delay in the gps do routine if the serial character buffer is empty.  GPS just got turned back on.  It may be some time before a character shows up.

Closed 2015-07-01.

Thread 3 (2015-06-18):

LED (D13) doesn't come on during CW ID

K6TD, 2015-06-18:
But, it does turn on during long Dash.

GeoNomad, 2015-06-19:
I can't find the lower level code for the cwBeacon functionality to look at these issues. Am I missing something?

K6TD, 2015-06-23:
Fixed.  SHA e8ab444f14f804c1e611ce34e53b1894f8e4d3e4.
Added code in send_id to turn on/off the LED.  Normally, this would be done in the rig.txon() function, but that function isn't called for CW ID.

Closed 2015-06-23.

Thread 4 (2015-06-18):

Frequency table

GeoNomad, 2015-06-18:
The setup assumes the radios will tune exactly to the beacon frequencies. I am not sure if the new radios will be equipped with TCXOs and calibrated on all 5 bands.

It might be advantageous to be able to adjust the transmit frequency sent to the radio for each band through the UI.

Just a suggestion.

K6TD, 2015-06-18:
Checking with ICOM - N9JA.  The spec sheet show info for resolution and stability only.

K6TD, 2015-06-19:
Broke out high performance frequency counter (HP 55151A).  Will measure the tow IC7200s here.

K6TD, 2015-06-19:
Ray says the radio is DDS, so once passes factory cal, should be within the stability spec- 10Hz.

GeoNomad, 2015-06-20:
Sounds good. The earlier IBP2 spec called for using the GPS to calibrate frequency counting and adjust the frequency as necessary. We can leave that for IBP 2.5

Thread 5 (2015-06-19):

Libraries aren't all in Git Hub

K6TD, 2015-06-19:
Seems that arduinomorse didn't get pushed to our repo.

K6TD, 2015-07-06:
libraries that are already on github, have a remote of their source repos.  Adding a second remote pointing to IBPV2 creates a mess.  Will have to research how to pull in other repos.  Might have to do a git pull trigger. :-).

Thread 8 (2015-06-26):

Time too long between end of call sign and start of long dash sequence

tomnd2t, 2015-06-26:
At K6TD today I listened to the IBPV2 prototype transmit.. It seems to me (by ear -- no measurement made) that the time between the end of the call sign and the beginning of the first long dash is greater than in the IBPV1 beacons on the air.

tomnd2t, 2015-06-29:
There are IBP1 sound samples on http://www.ncdxf.org/beacon/beaconschedule.html. Long call or short, the time is constant between the end of the call and the start of the first long dash. Listen, for example, to w6wx (weight = 52) and vk6rbp (weight = 74).

Callsign	Weight	Time (12wpm)	Time (16wpm)	Time (20wpm)	Dots	Dashes
w6wx	52	4.9 seconds	3.7 seconds	2.9 seconds	8	7
vk6rbp	74	7.1 seconds	5.3 seconds	4.3 seconds	15	8

tomnd2t, 2015-06-29:
Alex, VE3NEA might know the answer as he is the author of Faros.

wa5znu, 2015-06-29:
Does the first long dash start on a second boundary, or is it just some distance after the last letter of the call?

wa5znu, 2015-06-29:
Changing to K6TD/B might make the perceived distance shorter if it's supposed to start on a boundary.
The code currently starts on the same boundary for each beacon, not the "next" second.

tomnd2t, 2015-06-29:
From listening, I believe it starts some distance from the last letter of the call -- no matter how long or short the call. Peter Jennings wrote in an email earlier today:

"... A quick glance at the old code gives the answer to the long dash timing. The CW ID is sent. Then there is a 54 x 4 mSec delay. Then the long dash is sent. ..."

K6TD, 2015-07-01:
The full info from Peter is:
http://www.ncdxf.org/beacon/source.txt

A quick glance at the old code gives the answer to the long dash timing.

The CW ID is sent. Then there is a 54 x 4 mSec delay. Then the long
dash is sent. For perfect replication of the old beacon, the call
overhead would also have to be factored in. Adding the overhead for
8748 assembler minus Arduino overhead, depending on clock frequency.

anl bus,#0efh ;key PTT on rig
mov a,#mcall-100h ;transmit call
call morse
mov r7,#4 ;finish word space: wait four more els
xmi5: call el
djnz r7,xmi5

call long ;transmit one-second long dash

4U1UN/B is the longest call possible.

K6TD, 2015-07-01:
The timing wheel increments in seconds.  To fit in the 216ms delay, at the end of the call, we have to make the 1st long dash as part of the call time slot.

tomnd2t, 2015-07-02:
Quick and possibly dirty solution: Wait until the next wheel increment (next second). See who complains / what breaks. It would be an easy way to know, by ear, whether an on-air beacon is v1 or v2.

wa5znu, 2015-07-02:
That's definitely a good solution in my book!
Leigh/Wa5ZNU
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

tomnd2t, 2015-07-02:
And if too much breaks, repeat until it doesn't (divide each increment into 2, double counts, try again)

K6TD, 2015-07-06:
Trying to test with FAROS.  Once that picks up the new beacon, then we have timing right.

Thread 9 (2015-06-29):

Missing long dashes

K6TD, 2015-06-29:
ND2T reports not hearing the 1st long dash - at least on 15m.

K6TD, 2015-06-29:
This is problem of not putting the CW key "down" at the start of the dash.  Because of the way the time wheel works, problem is only true for 1st long Dash.

K6TD, 2015-07-01:
still debugging.  It's definitely the last, or fourth dash that is missing.  This might be a race condition in schedule loop, as it looks like the next 1PPS happens before the scheduler exists.  Probably due to all the time taken up by all the debug print statements.

wa5znu, 2015-07-01:
Good observation about the Heisenberg.  115Kbaud is pretty fast but maybe we should try taking the debug print out.

K6TD, 2015-07-01:
surprizingly, fixing issue #13 caused the 3rd long dash, as well as the 4th long dash to nougat sent.

wa5znu, 2015-07-03:
taking out sprintf made something worse?

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

K6TD, 2015-07-06:
Fixed with new schedule loop.  Committed into master

Closed 2015-07-06.

Thread 11 (2015-07-01):

LCD display seems to drop set cursor commands

K6TD, 2015-07-01:
Could be a time to execute command issue.

K6TD, 2016-05-31:
New Haven Display - the vendor, suggested using a I2C bus speed of 50kHz, down from 100kHz.  That seems to work.  Will continue to test.

K6TD, 2016-07-12:
Tested, works, done

Closed 2016-07-12.

Thread 12 (2015-07-01):

Make Serial Debug Print Optional

wa5znu, 2015-07-01:
[ISSUE-9] may be affected by Serial Debug Print.

K6TD, 2015-07-02:
Merged ISSUE-12 branch with bug_fixes branch, compiled and load.  No change without debug print statements.

K6TD, 2015-07-02:
Merged this branch into bug_fixes, tested, merged bug_fixes into master.

Closed 2015-07-02.

Thread 15 (2015-07-02):

CW ID on 20m seems weak compared to the 1st long dash.

K6TD, 2015-07-02:
Power meter on rigs shows the CW at about 75% power for the CW ID, then jumps to full power for the dash.  Seems to be correct power levels for the other bands.

First observed by Peter.

K6TD, 2015-07-02:
Power is actually at 50% of full scale, or 50 watts, according to power meter. WTF

K6TD, 2015-07-06:
Fixed.  Committed into master.

Closed 2015-07-06.
