IronHeartConsulting/IBPV2/Hardware/Enclosure/IBPV2_front_panel_Rev_A.pdf

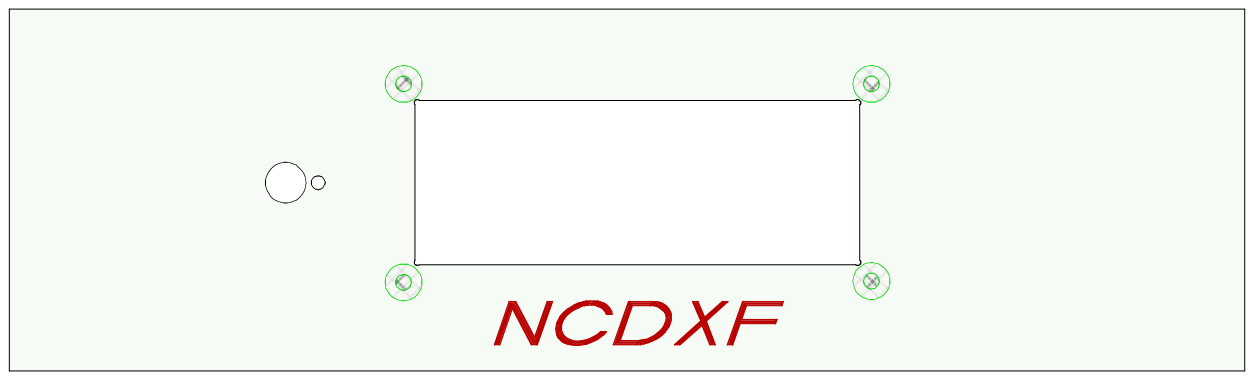
[picture p18: page 1]
