IronHeartConsulting/IBPV2/Hardware/Enclosure/IBPV2_rear_panel_Rev_A.pdf

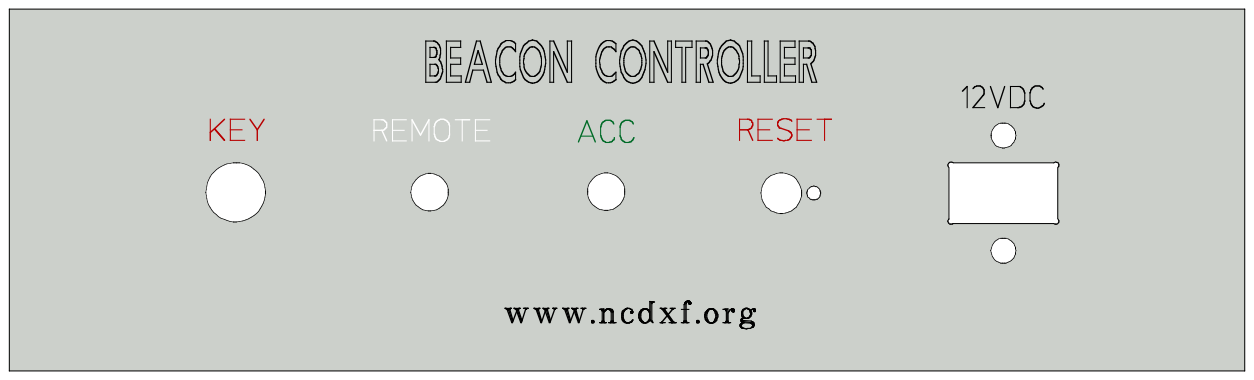
[picture p19: page 1]
