IronHeartConsulting/IBPV2/Hardware/Electricial/Rev E controller/CI_V_Shield_Rev_D/CI_V.brd

## EAGLE design Hardware/Electricial/Rev E controller/CI_V_Shield_Rev_D/CI_V.brd (2016-09-22)

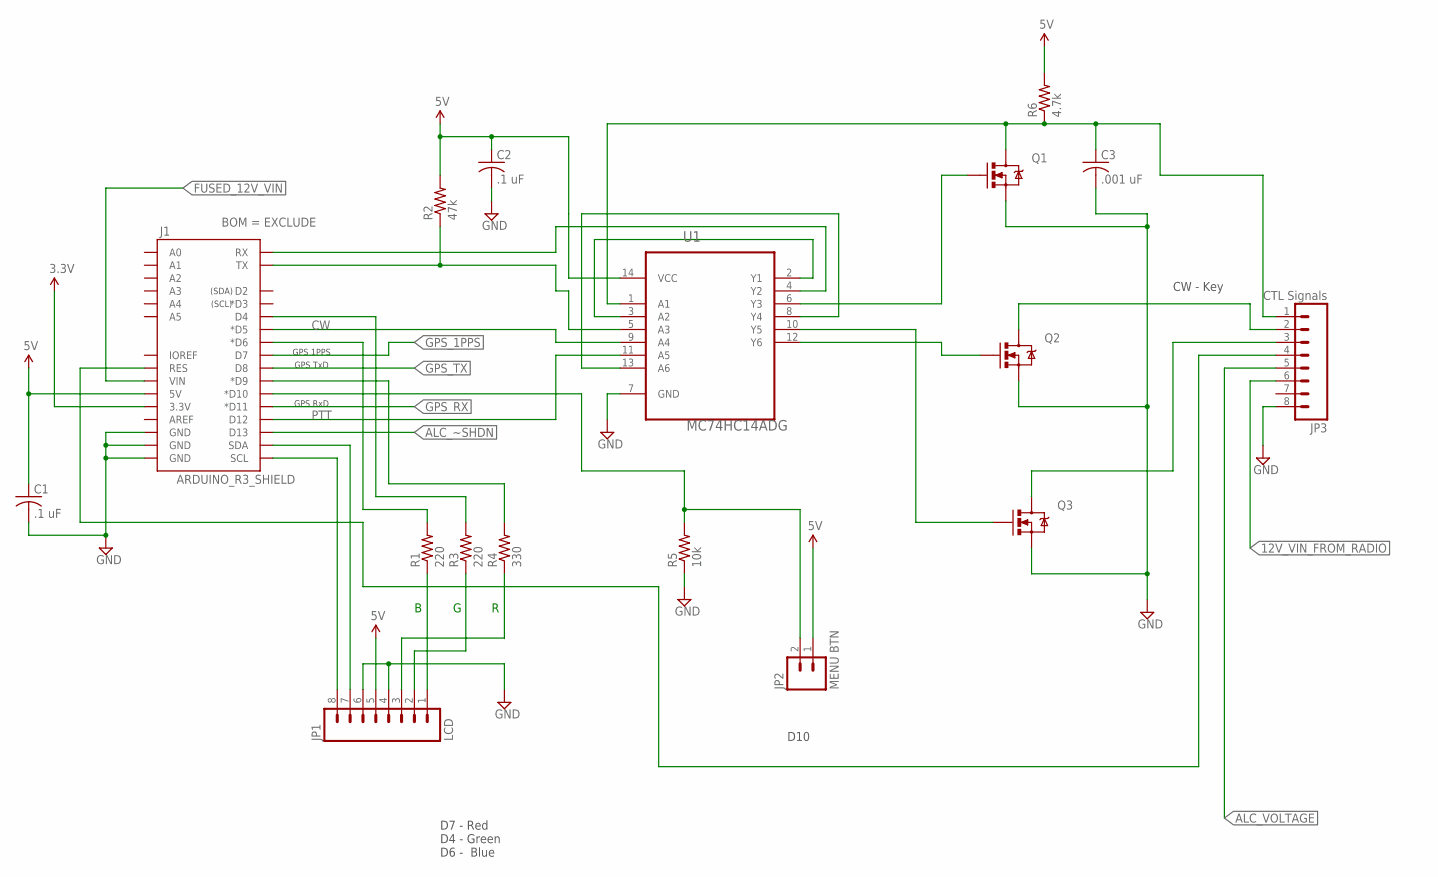
[picture p20: schematic CI_V.sch, sheet 1, CI-V Arduino Shield]

Parts:
C1, C2: .1 uF; C0805; PARTNO 120-0001-010
C3: .001 uF; C0805; PARTNO 120-0001-015
J1: ARDUINO_R3_SHIELD; UNO_R3_SHIELD
JP1: LCD; 1X08_PIN1_NO_SILK; PARTNO 125-0019-001
JP2: MENU BTN; 1X02; PARTNO 125-0019-001
JP3: CTL Signals; 1X08_PIN1_NO_SILK; PARTNO 125-0019-001
Q1, Q2, Q3: MOSFET-NCHANNELBSS123LT1G; SOT23-3; PARTNO 185-0001-001
R1, R3: 220; R0805; PARTNO 110-0001-010
R2: 47k; R0805; PARTNO 110-0001-030
R4: 330; R0805; PARTNO 110-0001-025
R5: 10k; R0805; PARTNO 110-0001-025
R6: 4.7k; R0805; PARTNO 110-0001-030
U1: MC74HC14ADG; SOIC127P600X175-14N; PARTNO 200-0001-001

Connections:
3.3V: J1.3.3V; also elsewhere on the board
5V: C1.1, C2.1, J1.5V, JP1.5, JP2.1, R2.2, R6.2, U1.14 (VCC); also elsewhere on the board
12V_VIN_FROM_RADIO: JP3.6; also elsewhere on the board
ALC_VOLTAGE: JP3.5; also elsewhere on the board
ALC_~SHDN: J1.D13; also elsewhere on the board
CW: J1.D5 (*D5), U1.9 (A4)
FUSED_12V_VIN: J1.VIN; also elsewhere on the board
GND: C1.2, C2.2, C3.2, J1.GND@0 (GND), J1.GND@1 (GND), J1.GND@2 (GND), JP1.4, JP1.6, JP3.8, Q1.2 (S), Q2.2 (S), Q3.2 (S), R5.1, U1.7 (GND); also elsewhere on the board
GPS_1PPS: J1.D7; also elsewhere on the board
GPS_RX: J1.D11 (*D11); also elsewhere on the board
GPS_TX: J1.D8; also elsewhere on the board
HARD_RX: J1.RX, U1.4 (Y2)
HARD_TX: J1.TX, R2.1, U1.5 (A3)
unnamed: C3.1, JP3.1, Q1.3 (D), R6.1, U1.1 (A1)
unnamed: JP3.2, Q2.3 (D)
unnamed: JP3.3, Q3.3 (D)
unnamed: Q1.1 (G), U1.6 (Y3)
unnamed: JP1.1, R1.1
unnamed: JP1.2, R3.1
unnamed: U1.2 (Y1), U1.3 (A2)
unnamed: Q2.1 (G), U1.12 (Y6)
unnamed: Q3.1 (G), U1.10 (Y5)
unnamed: J1.SCL, JP1.8
unnamed: U1.8 (Y4), U1.13 (A6)
unnamed: J1.SDA, JP1.7
unnamed: JP1.3, R4.1
unnamed: J1.D6 (*D6), R1.2
unnamed: J1.D4, R3.2
unnamed: J1.D9 (*D9), R4.2
unnamed: J1.D10 (*D10), JP2.2, R5.2
unnamed: J1.RES, JP3.4
PTT: J1.D12, U1.11 (A5)

Notes on the sheet:
CW - Key
D7 - Red D4 - Green D6 - Blue
D10
GPS TxD
GPS RxD
GPS 1PPS

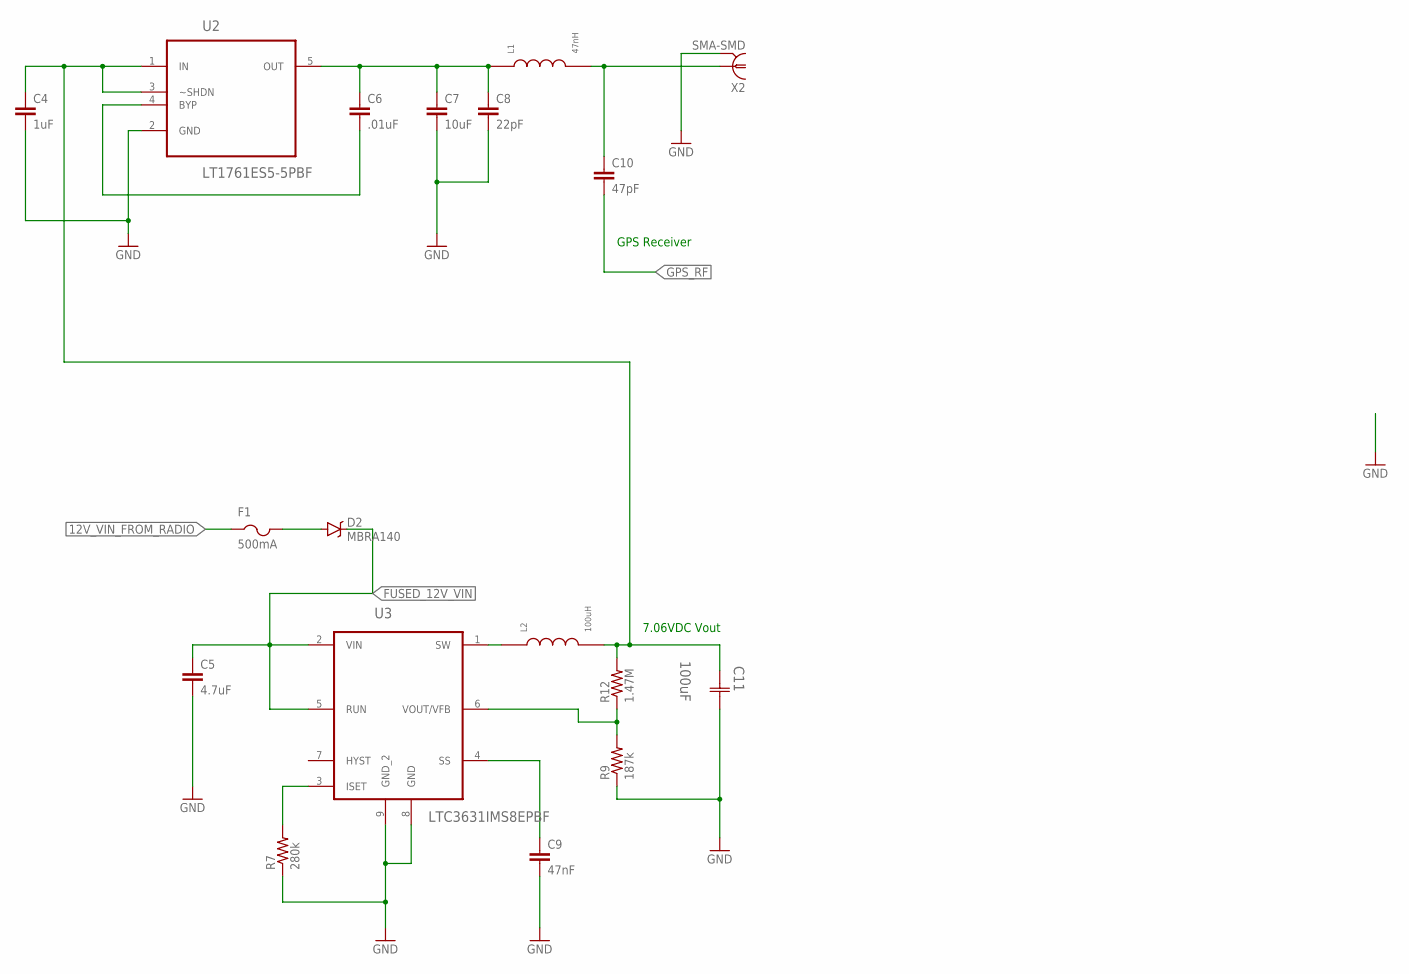
[picture p21: schematic CI_V.sch, sheet 2, Power]

Parts:
C4: 1uF; 0805; PARTNO 120-0001-015
C5: 4.7uF; 1210; PARTNO 120-0003-011
C6: .01uF; 0805; PARTNO 120-0001-020
C7: 10uF; 1210; PARTNO 120-0003-010
C8: 22pF; 0805; PARTNO 120-0004-011
C9: 47nF; 0805; PARTNO 120-0001-013
C10: 47pF; 0805; PARTNO 120-0004-010
C11: 100uF; CAPCP6032X280N; PARTNO 120-0005-050
D2: MBRA140; SMA-DIODE; PARTNO 140-0001-001
F1: 500mA; R1206; PARTNO 145-0001-001
L1: 47nH; 0805; PARTNO 155-0002-001
L2: 100uH; SLF7045; PARTNO 155-0001-001
R7: 280k; 0805; PARTNO 110-0002-015
R9: 187k; 0805; PARTNO 110-0002-020
R12: 1.47M; 0805; PARTNO 110-0002-010
U2: LT1761ES5-5PBF; SOT95P280X100-5N; PARTNO 230-0002-001
U3: LTC3631IMS8EPBF; SOP65P490X110-9N; PARTNO 230-0003-001
X2: SMA-SMD; PARTNO 125-0018-001

Connections:
7V_BUS: C4.1, C11.1 (C1), L2.2, R12.2, U2.1 (IN), U2.3 (~SHDN)
12V_VIN_FROM_RADIO: F1.1; also elsewhere on the board
FUSED_12V_VIN: C5.1, D2.C, U3.2 (VIN), U3.5 (RUN); also elsewhere on the board
GND: C4.2, C5.2, C7.2, C8.2, C9.2, C11.2 (C2), R7.1, R9.1, U2.2 (GND), U3.8 (GND), U3.9 (GND_2), X2.2@1 (2), X2.2@2 (2), X2.2@3 (2), X2.2@4 (2), X2.2@5 (2), X2.2@6 (2); also elsewhere on the board
GPS_RF: C10.2; also elsewhere on the board
ISET: R7.2, U3.3 (ISET)
unnamed: C10.1, L1.2, X2.1
unnamed: C6.2, U2.4 (BYP)
unnamed: D2.A, F1.2
SS: C9.1, U3.4 (SS)
SW: L2.1, U3.1 (SW)
VCC: C6.1, C7.1, C8.1, L1.1, U2.5 (OUT)
VFB: R9.2, R12.1, U3.6 (VOUT/VFB)

Notes on the sheet:
GPS Receiver
7.06VDC Vout

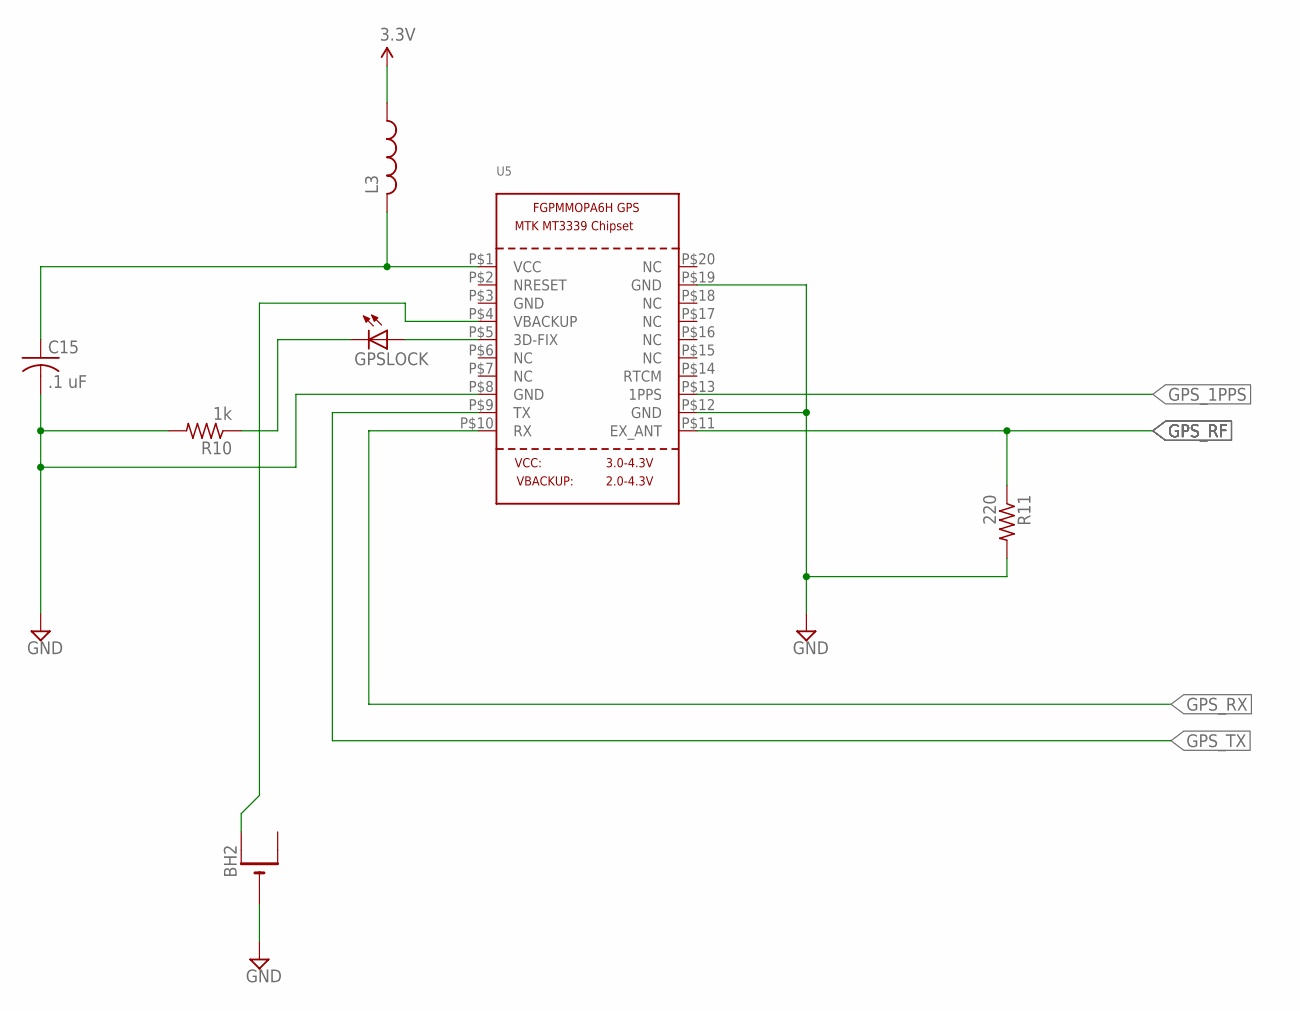
[picture p22: schematic CI_V.sch, sheet 3, GPS Receiver]

Parts:
BH2: CR1220SMT; CR1220-SMD; PARTNO 165-0001-001
C15: .1 uF; C0805; PARTNO 120-0001-010
GPSLOCK: LEDCHIPLED_0805; CHIPLED_0805; PARTNO 160-0007-001
L3: L-USL2012C; L2012C; PARTNO 155-0004-001
R10: 1k; R0805; PARTNO 110-0001-029
R11: 220; R0805; PARTNO 110-0001-010
U5: GPS_FGPMMOPA6H; FGPMMOPA6H; PARTNO 240-0001-001

Connections:
3.3V: L3.1; also elsewhere on the board
GND: BH2.-, C15.2, R10.2, R11.2, U5.P$8 (GND), U5.P$12 (GND), U5.P$19 (GND); also elsewhere on the board
GPS_1PPS: U5.P$13 (1PPS); also elsewhere on the board
GPS_BATT: BH2.+$1 (+), U5.P$4 (VBACKUP)
GPS_RF: R11.1, U5.P$11 (EX_ANT); also elsewhere on the board
GPS_RX: U5.P$10 (RX); also elsewhere on the board
GPS_TX: U5.P$9 (TX); also elsewhere on the board
unnamed: C15.1, L3.2, U5.P$1 (VCC)
unnamed: GPSLOCK.A, U5.P$5 (3D-FIX)
unnamed: GPSLOCK.C, R10.1

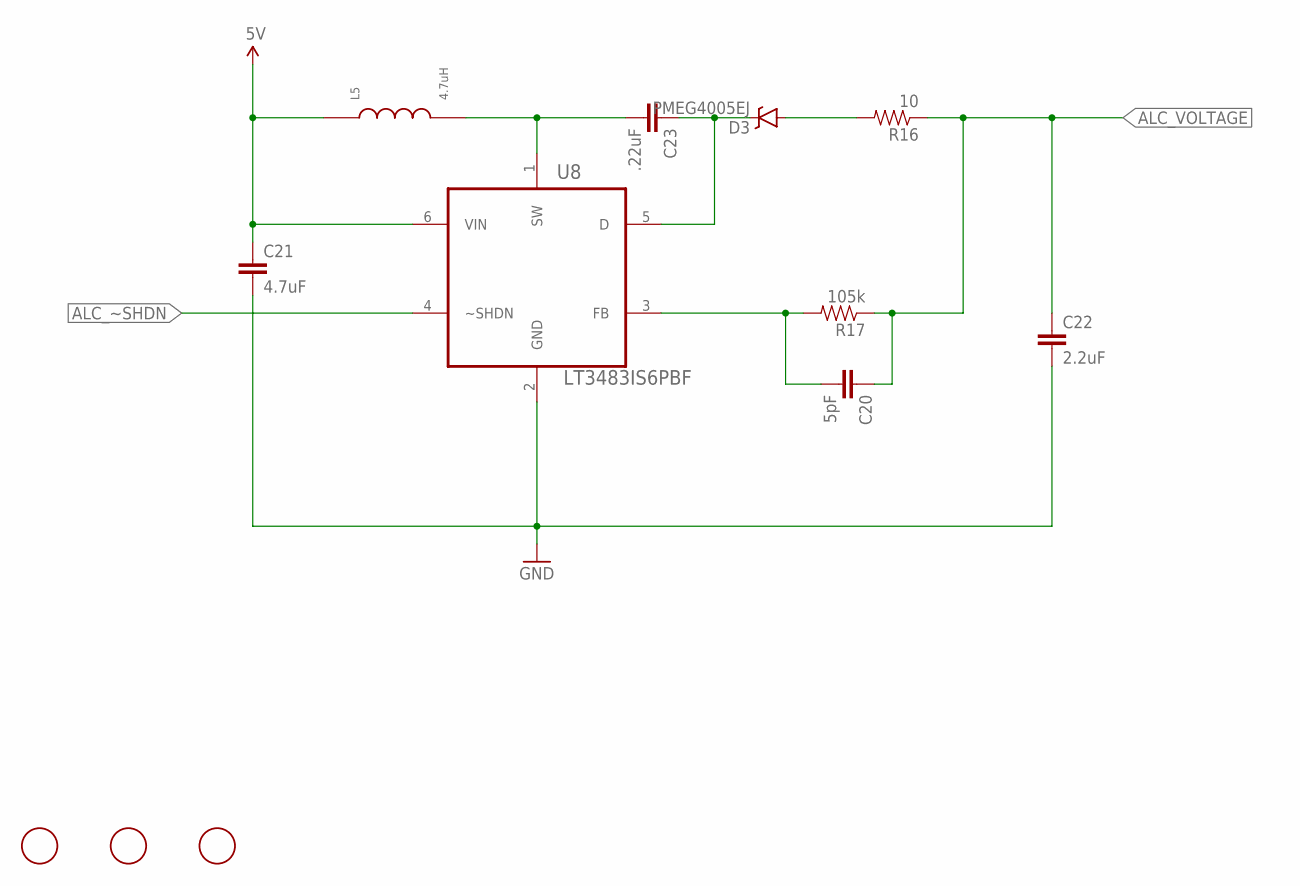
[picture p23: schematic CI_V.sch, sheet 4, ALC control]

Parts:
C20: 5pF; 0805; PARTNO 120-0004-010
C21: 4.7uF; 1210; PARTNO 120-0003-011
C22: 2.2uF; 0805; PARTNO 120-0002-011
C23: .22uF; 0805; PARTNO 120-0001-022
D3: PMEG4005EJ; SOD-323; PARTNO 140-0002-001
L5: 4.7uH; 0805; PARTNO 155-0003-001
R16: 10; 0805; PARTNO 110-0001-027
R17: 105k; 0805; PARTNO 110-0003-010
U8: LT3483IS6PBF; SOT95P280X100-6N
U$1, U$6, U$7: FIDUCIAL; FIDUCIAL_1MM

Connections:
5V: C21.1, L5.1, U8.6 (VIN); also elsewhere on the board
ALC_VOLTAGE: C20.1, C22.1, R16.1, R17.1; also elsewhere on the board
ALC_~SHDN: U8.4 (~SHDN); also elsewhere on the board
GND: C21.2, C22.2, U8.2 (GND); also elsewhere on the board
unnamed: D3.A, R16.2
unnamed: C23.2, L5.2, U8.1 (SW)
unnamed: C23.1, D3.C, U8.5 (D)
unnamed: C20.2, R17.2, U8.3 (FB)

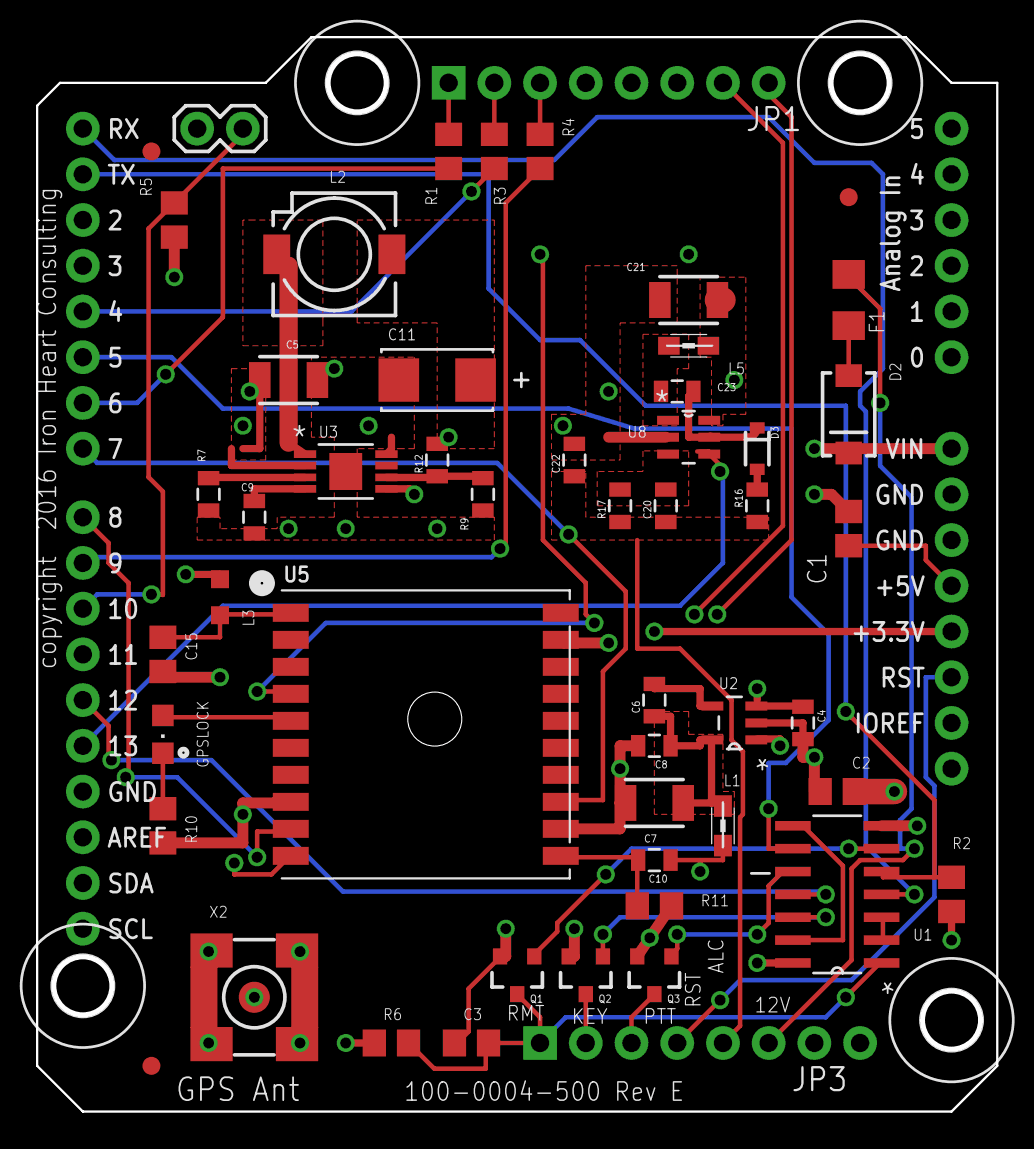
[picture p24: board CI_V.brd from above]

Board: 4 copper layers, 53.3 x 59.7 mm, 58 parts (1 on the bottom side), 50 nets.

Other parts of the board:
U$2, U$3, U$4, U$5: 3,2
