IronHeartConsulting/IBPV2/Hardware/Electricial/CI_V_REV_A.brd

## EAGLE design Hardware/Electricial/CI_V_REV_A.brd (2015-05-12)

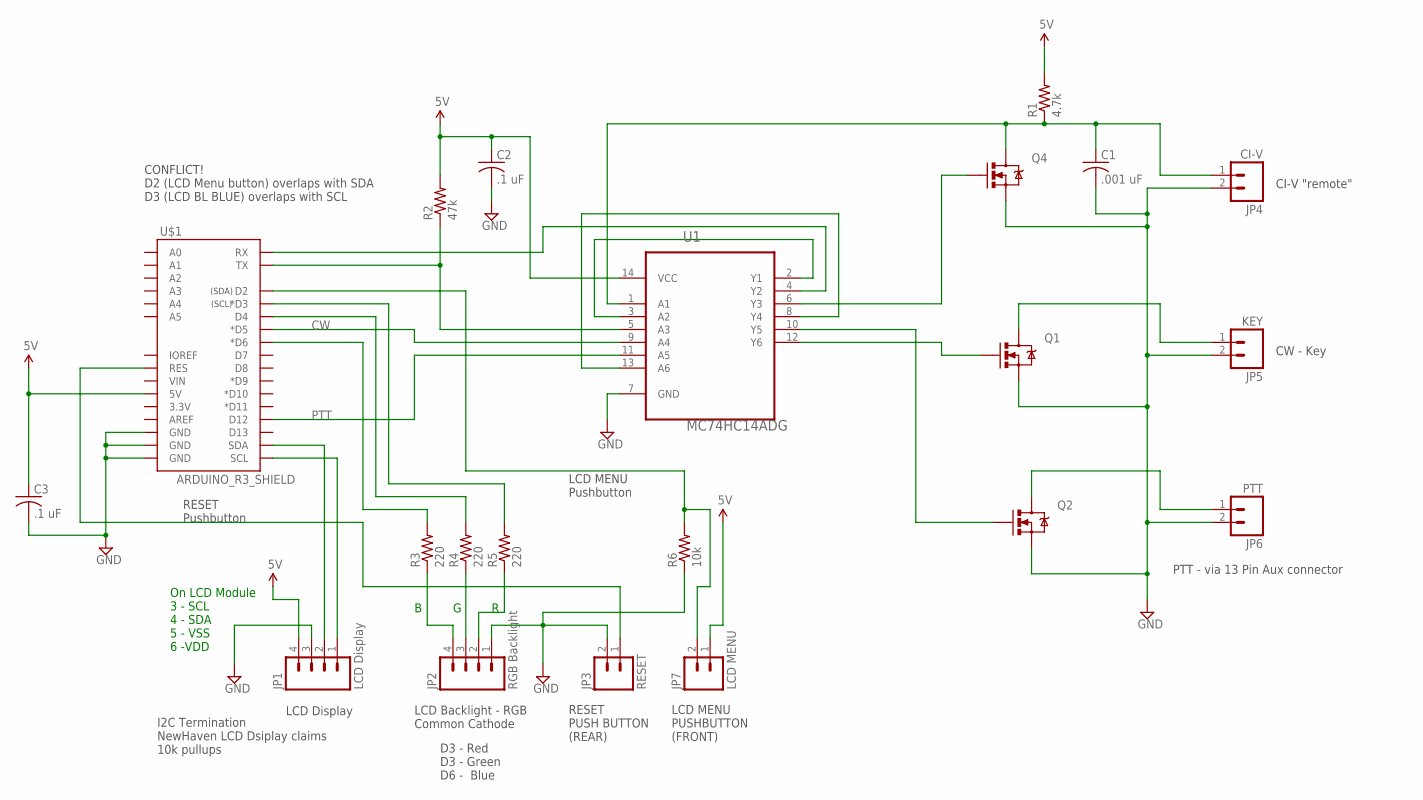
[picture p25: schematic CI_V_REV_A.sch, CI-V Arduino Shield]

Parts:
C1: .001 uF; C0805
C2, C3: .1 uF; C0805
JP1: LCD Display; 1X04
JP2: RGB Backlight; 1X04
JP3: RESET; 1X02
JP4: CI-V; 1X02
JP5: KEY; 1X02
JP6: PTT; 1X02
JP7: LCD MENU; 1X02
Q1, Q2, Q4: MOSFET-NCHANNELBSS123LT1G; SOT23-3
R1: 4.7k; R0805
R2: 47k; R0805
R3, R4, R5: 220; R0805
R6: 10k; R0805
U1: MC74HC14ADG; SOIC127P600X175-14N
U$1: ARDUINO_R3_SHIELD; UNO_R3_SHIELD

Connections:
5V: C2.1, C3.1, JP1.4, JP7.1, R1.2, R2.2, U1.14 (VCC), U$1.5V
CW: U1.9 (A4), U$1.D5 (*D5)
GND: C1.2, C2.2, C3.2, JP1.3, JP2.1, JP3.2, JP4.2, JP5.2, JP6.2, Q1.2 (S), Q2.2 (S), Q4.2 (S), R6.1, U1.7 (GND), U$1.GND@0 (GND), U$1.GND@1 (GND), U$1.GND@2 (GND)
HARD_RX: U1.4 (Y2), U$1.RX
HARD_TX: R2.1, U1.5 (A3), U$1.TX
unnamed: C1.1, JP4.1, Q4.3 (D), R1.1, U1.1 (A1)
unnamed: JP5.1, Q1.3 (D)
unnamed: JP6.1, Q2.3 (D)
unnamed: Q4.1 (G), U1.6 (Y3)
unnamed: JP2.4, R3.1
unnamed: JP2.3, R4.1
unnamed: U1.2 (Y1), U1.3 (A2)
unnamed: Q1.1 (G), U1.12 (Y6)
unnamed: Q2.1 (G), U1.10 (Y5)
unnamed: JP1.1, U$1.SCL
unnamed: U1.8 (Y4), U1.13 (A6)
unnamed: JP1.2, U$1.SDA
unnamed: JP2.2, R5.1
unnamed: R3.2, U$1.D6 (*D6)
unnamed: R4.2, U$1.D4
unnamed: R5.2, U$1.D3 (*D3)
unnamed: JP7.2, R6.2, U$1.D2
unnamed: JP3.1, U$1.RES
PTT: U1.11 (A5), U$1.D12

Notes on the sheet:
CI-V "remote"
CW - Key
PTT - via 13 Pin Aux connector
I2C Termination NewHaven LCD Dsiplay claims 10k pullups
LCD Display
LCD Backlight - RGB Common Cathode
On LCD Module 3 - SCL 4 - SDA 5 - VSS 6 -VDD
RESET PUSH BUTTON (REAR)
LCD MENU PUSHBUTTON (FRONT)
RESET Pushbutton
LCD MENU Pushbutton
D3 - Red D3 - Green D6 - Blue
CONFLICT! D2 (LCD Menu button) overlaps with SDA D3 (LCD BL BLUE) overlaps with SCL

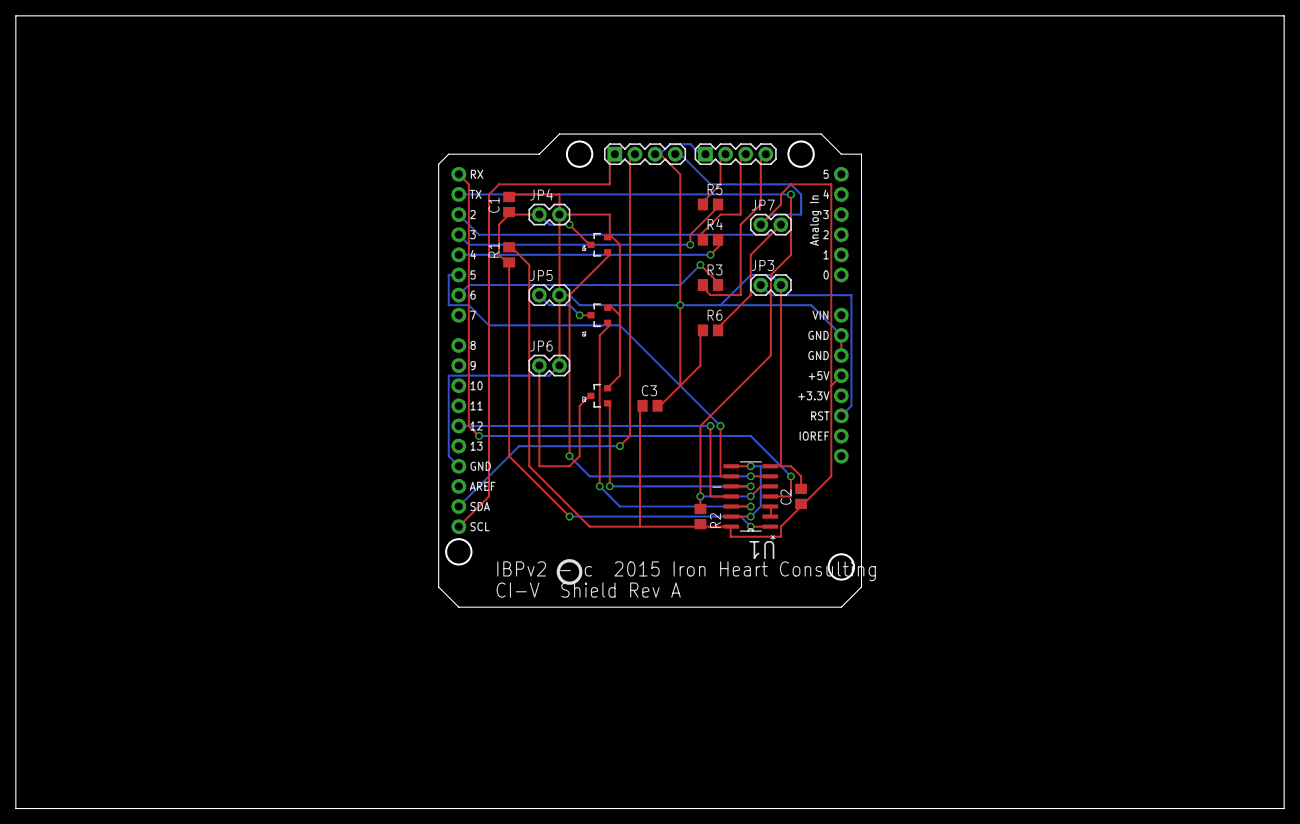
[picture p26: board CI_V_REV_A.brd from above]

Board: 2 copper layers, 160.0 x 100.0 mm, 21 parts (0 on the bottom side), 24 nets.
