IronHeartConsulting/IBPV2/beacon/softreset.h

#ifndef _SOFT_RESTART_H
#define _SOFT_RESTART_H

#include <avr/wdt.h>

#define soft_restart()        \
do                          \
{                           \
    wdt_enable(WDTO_15MS);  \
    for(;;)                 \
    {                       \
    }                       \
} while(0)

#endif
