IronHeartConsulting/IBPV2/beacon/softreset.ino

#include <stdint.h>
#include <avr/wdt.h>

void wdt_init(void) __attribute__((naked)) __attribute__((section(".init3")));
// Function Implementation
void wdt_init(void)
{
    MCUSR = 0;
    wdt_disable();

    return;
}
