IronHeartConsulting/IBPV2/beacon/gps_do.ino

void gps_begin_milliclock_discipline() {
  disciplining_milliclock = true;
}

void gps_end_milliclock_discipline() {
  disciplining_milliclock = false;
  if (millis_per_second != 0) {
    seven_fifty_millis = (millis_per_second * 3 / 4);
    debug_print(F("Disciplined 750 millis to ")); 
    debug_println(seven_fifty_millis);
  }
}

/**
 * Spend some time trying to get a GPS time.  If we fail, wall_ticks will be messed up.
 * If we succeed, wall_ticks will be right.
 *
 * The GPS SoftwareSerial is off unless we're using it, because 
 * it generates interrupts, and that would disturb out timing.  This
 * routine enables here and disables it before exit.
 */
boolean gps_discipline_clock(long tries) {
  boolean done = false;
  debug_println(F("*** GPS Discipline clock start"));
  Serial.flush();

  // Enable SoftwareSerial; disable before exit.
  gps_serial.listen();

  while (--tries > 0) {
    // attend to GPS in event loop
    // not necessary all the time, but does need to happen to keep time sync
    if (gps_serial.available()) {
      char c = gps_serial.read();
      if (true) {
        if (true) {
          Serial.write(c);   Serial.flush();
        }

        if (gps.encode(c)) {
          debug_newline();
          // what about GPS.milliseconds?  Should we do this only if it is in a certain range?
          int year;
          byte month, day, hour, minute, second, hundredths;
          unsigned long fix_age;
          gps.crack_datetime(&year, &month, &day, &hour, &minute, &second, &hundredths, &fix_age);
		  if (fix_age != gps.GPS_INVALID_AGE) {
          // about to write into wall_ticks but how do we know we're not about to interrupt?
          // maybe we should increment it by one and let interrupt write it itself.  that's assuming
          // the gps decode happens enough before the PPS.
          //
          //   Move to "the other side of the the 1PPS tick"
          //  The message appears to arrive AFTER the 1 second tick
          	wall_ticks = 1 + ((minute * 60) + second) % (3*60);
          	debug_print(F("handle_gps_parsing says update wall_ticks to "));
          	debug_print(wall_ticks);
          	debug_print(F(" fix age "));
          	debug_print(fix_age);
          	debug_println(F("ms"));
          	done = true;
          	break;
		  }
		  else { // fix_age !=
			Serial.print(F("fix age INVALID"));
			break;
		  }
        }  // gps.encode()
      } // if(true)  - if gps_serial.read() retunred a character
    } // if gps_serial says there are characters available
	else {
		delay(100);  // give time for chars to arrive
	}
  }   // while retries > 0

  gps_serial.stopListening();

  debug_print(F("*** GPS Discipline clock done: "));
  debug_println(done);
  Serial.flush();

  return done;
}
