IronHeartConsulting/IBPV2/beacon/cw.h

//                         Time (22wpm)
// Callsign	Units	Units * 1.2 / 22
// VE8AT	48	    2.6 sec
// OA4B		48	    2.6 sec
// 4S7B		50	    2.7 sec
// CS3B		50	    2.7 sec
// W6WX		52	    2.8 sec
// ZL6B		52	    2.8 sec
// VR2B		52	    2.8 sec
// 5Z4B		52	    2.8 sec
// LU4AA	52	    2.8 sec
// YV5B		52	    2.8 sec
// RR9O		54	    2.9 sec
// ZS6DN	54	    2.9 sec
// OH2B		54	    2.9 sec
// 4X6TU	58	    3.2 sec
// 4U1UN	62	    3.4 sec
// KH6WO	62	    3.4 sec
// VK6RBP	74	    4.0 sec
// JA2IGY	76	    4.1 sec
