IronHeartConsulting/IBPV2/util/load_eeprom/config.h

#ifndef CONFIG_H
#define CONFIG_H

//  compile time to inlude debugging versions of printf's and actually use them.
#define DEBUG 1

// now read thru EEPROM value
//   value are index into stations array - 0 ->17
//   255 means unknown, don't TX
#define SLOTINDEX 14

#endif
