IronHeartConsulting/IBPV2/(commit log)

2014-07-23 Add references directory with critical documents (schematic, source code) from v1.0 project
2014-07-24 Add test mode, switches, LED replaced by LCD
2014-07-24 Add switch/CD reocmmendations.
2015-05-01 add back in the correct version of Leigh's code
    [BCN_LCD_1.ino, beacon.h, beacon.ino, cw.h, gps_do.ino, id.ino, rig.ino, schedule.ino]
2015-05-12 added Rev A schematics; updated LCD testing sketch
    [CI_V_REV_A.brd, CI_V_REV_A.sch]
2015-05-14 1PP interrupt testing
2015-05-19 working out 1PS interrupt conflict
2015-05-28 local SoftwareSerial - start of fix interrupts
    [GPS_2.ino]
2015-06-03 working on interrupts
2015-06-16 bug fixes. Long DAH keying, frequency, and callsign in lower case
    [beacon.ino, id.ino, rig.ino, stations.h]
2015-06-16 added debug output samples
2015-06-17 fixed: no TX during CW ID
    [id.ino]
2015-06-19 LCD wiring ECO docs
2015-06-20 FP LCD now working. ECO needed for RED baclight
    [LCD_layout.xlsx]
2015-06-23 fixed LED during ID transmisison
    [beacon.ino, id.ino]
2015-06-24 Proposed fix to CW ID stutter.Eliminate interrupts generated by gps_serial by calling stopListening() and listen() around its use. Start off with stopListening().
    [beacon.ino, gps_do.ino]
2015-06-29 tested and on the air, albeit with a few bug reports
    [stations.h]
2015-06-29 added various debug and testing files
    [wall_ticks_mod.xlsx]
2015-06-29 changed station callsigns to lower case. Expected by morse code routine. Added test for no GPS fix
    [gps_do.ino, stations.h]
2015-06-29 added 20dBm/100 mW case statement
2015-06-29 forgot the actaully change the power level
2015-06-30 fix 18m frequency, fix powe rsetting for 20dBm, library category, so IDE shuts up
    [beacon.ino, rig.ino, schedule.ino]
2015-07-01 debug code for missing last dash; fixed GPS DO
    [wall_ticks_mod.xlsx]
2015-07-01 ISSUE-12: Make Serial Debug Print OptionalCannot test compile due to ISSUE-5 missing arduinomorse.
    [beacon.ino, config.h, debug.h, gps_do.ino, id.ino, rig.ino, schedule.ino]
2015-07-01 remove sprintf from schedule.ino. Issue-13
    [schedule.ino]
2015-07-02 complete testing of debug print - ISSUE-12
    [gps_do.ino, schedule.ino]
2015-07-08 fixed CW ID power on higher bands
    [schedule.ino]
2015-07-11 move to other side of 1PPS tick; inserted delay before start of CW ID - calibrated ot FAROS
2015-07-29 working leo reset now. Populate and make work on a BBB
    [Blink.ino]
2016-01-02 Added BOM for power injector stored copy of beacon list from faros updated debug and version
    [Power_Injector_Asm_kit.xlsx]
2016-06-01 Added IC-7300 documentation added power control testing info fixed LCD display dropped characters - decreased I2C bus speed to 50KHz Tested with Rev B controller changed station selection to be a #de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
    [LCD_layout.xlsx, N6XG_Icom 7200 Power Control.xlsx, power_measuring.xlsx]
2016-06-16 spreadsheet for tracking power control ideas
    [power_levels.xlsx]
2016-07-18 add radio test software with CLI; station selection now done in config file as an index; spreadsheet for TX power calcs.
    [power_levels.xlsx]
2016-08-01 testing Rev C PCBA
    [power_levels.xlsx]
2016-09-22 add Rev B mechanical models
    [Front_endpanel.stl, Pan_withOUT_standoffs_Rev_B.stl, rear_endpanel.stl]
2016-10-11 add eeprom util, labels, read slot ID from EEPROM, update for VE8AT deployment
    [LCD_layout.xlsx]
2016-10-11 change LCD I2C freq back to 100kHz. 2X delay may affect TX loop performance
2016-10-13 put I2C back to 50kHz, reduce delay to start of TX to 134
2016-12-15 bug fixes
    [LCD_layout.xlsx]
2016-12-21 V2.9 release
    [slot_timing_duration.xlsx]
2016-12-27 fixed menu selection for timeslot
    [beacon.h, beacon.ino, eeprom_util.ino, menu.ino, stations.h]
2016-12-28 fixed radio init, more menu fixes, spelling errors. V2.11
    [beacon.h, beacon.ino, menu.ino, rig.ino]
