IronHeartConsulting/IBPV2/(notices)

Notices in the files:
Test Sketches/NHD/NHD_0216K3Z_mega.ino:
This program is free software; you can redistribute it and/or modify
it under the terms of the GNU General Public License as published by
the Free Software Foundation; either version 2 of the License, or
(at your option) any later version.
Hardware/Electricial/Rev E controller/CI_V_Shield_Rev_D/CI_V.brd:
copyright 2016 Iron Heart Consulting
parts and their libraries:
SparkFun-DiscreteSemi: Licensing: Creative Commons ShareAlike 4.0 International - https://creativecommons.org/licenses/by-sa/4.0
